ashertok1/BowelProbe/BowelProbe_Wordmark.jpeg

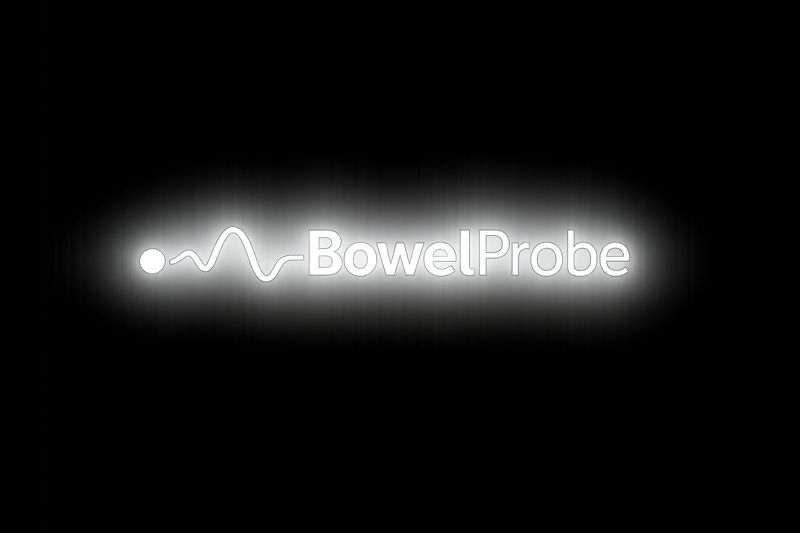
BowelProbe_Wordmark.jpeg
