ashertok1/BowelProbe/bowelProbeBlackAndWhite1.png

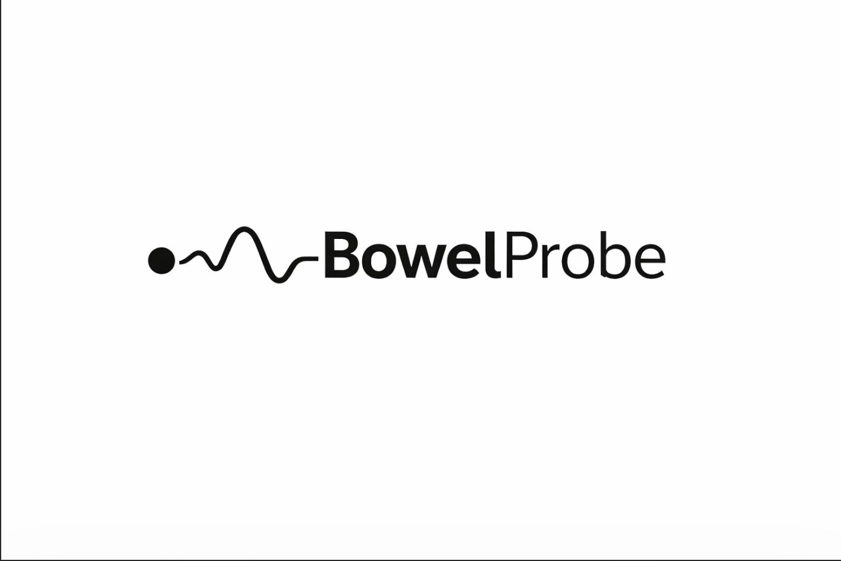
bowelProbeBlackAndWhite1.png
