ashertok1/BowelProbe/bowelProbeBlackAndWhite2.png

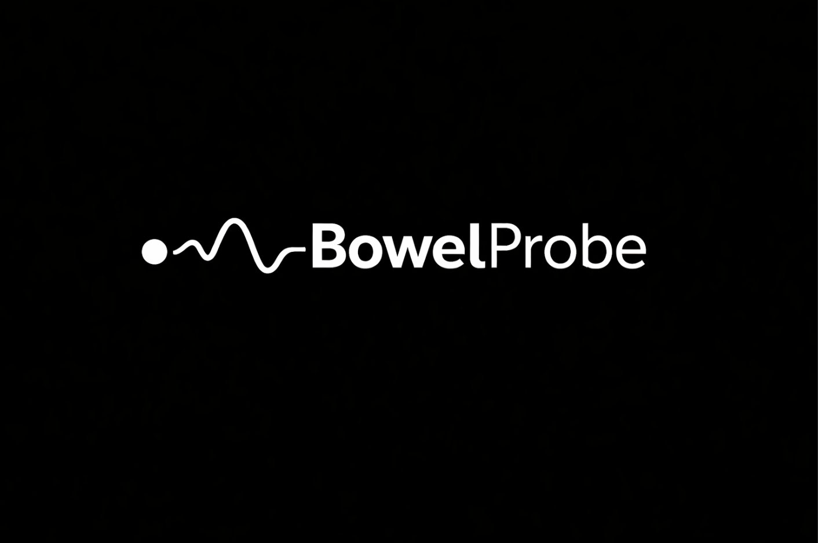
bowelProbeBlackAndWhite2.png
