ashertok1/BowelProbe/bowelProbe_3D/AO3407A.step

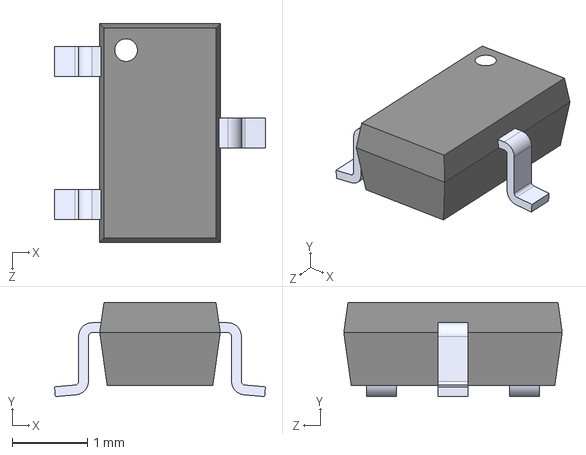
[picture p4: CAD file, 2026-07-04]
bowelProbe_3D/AO3407A.step
2.80 x 1.25 x 2.90 mm
