ashertok1/BowelProbe/HFSSsim/bowelProbe-drl_map.dxf

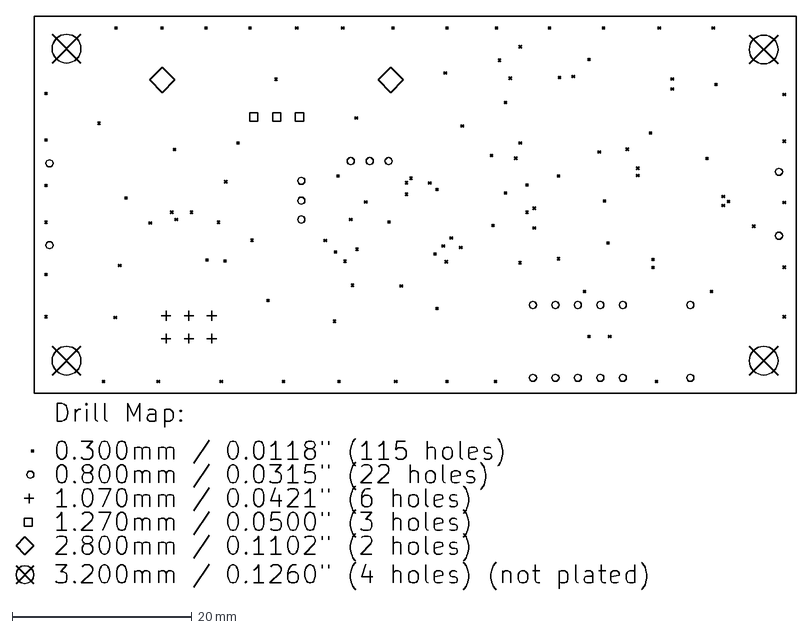
[picture p5: CAD file, 2026-03-30]
HFSSsim/bowelProbe-drl_map.dxf
86.7 x 63.8 mm
