ashertok1/BowelProbe/bowelProbe_3D/BZT52B12.step

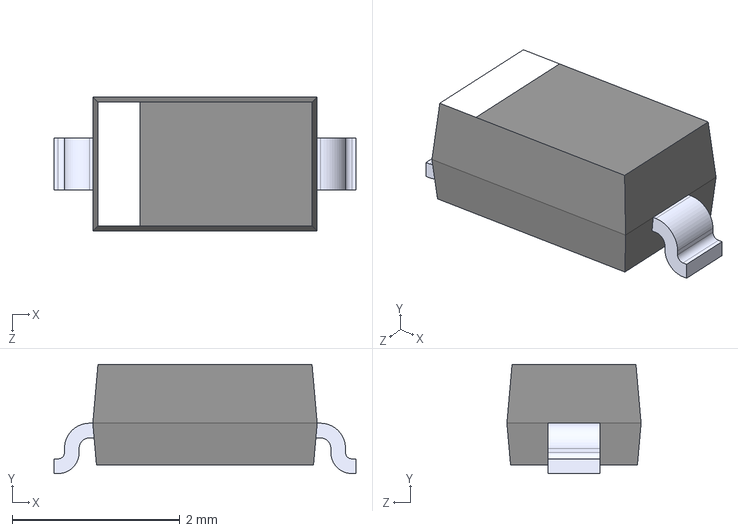
[picture p6: CAD file, 2026-07-04]
bowelProbe_3D/BZT52B12.step
3.60 x 1.30 x 1.60 mm
