ashertok1/BowelProbe/HFSSsim/.step

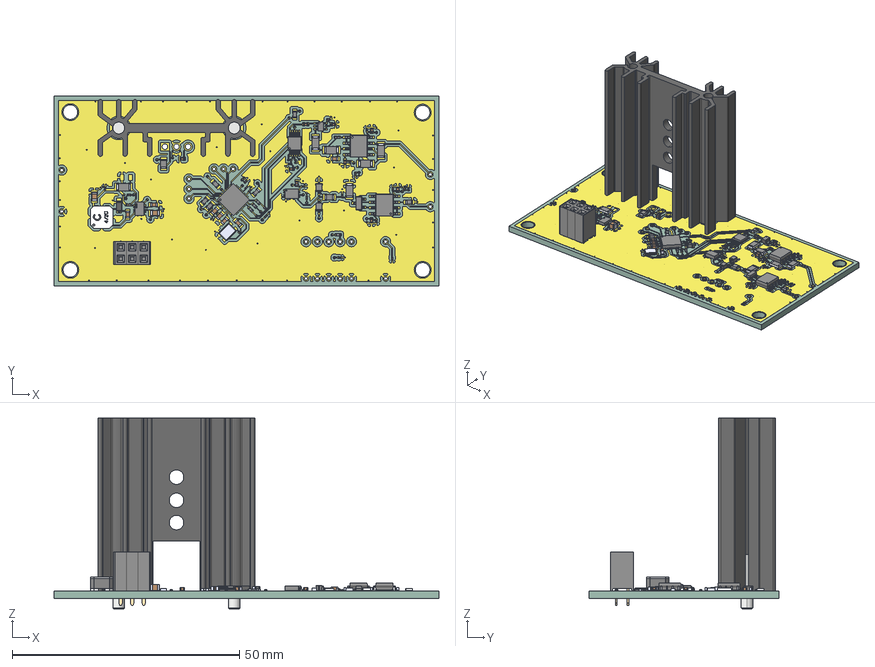
[picture p7: CAD file, 2026-03-30]
HFSSsim/.step
84.7 x 41.9 x 42.0 mm
Cap0.1uF x 22
Resistor6.8k x 2
Cap10uF x 9
Cap4.7pF
Resistor1M
CUS10S30,H3F x 2
MCP6002smd
Resistor10k x 4
Cap1uF x 4
Resistor47 x 4
NPPC202LFBN-RC_C03
Pin - Gold x 3
Buffer
Resistor1k x 2
DiodeLowLeak
Cap18pF x 2
Cap4.7uF x 2
Inductor10uH
Resistor100
Body001 (Mirror #1) x 8
XY-plane x 24
X-axis x 24
Crystal16MHz
Resistor30k
Cap2.2nF
Cap1nF
AD9833BRMZ
Resistor300k
LT8330
Heatsink
ATMEGA328P-MUR
Resistor1.8k
bowelProbe_copper
bowelProbe_PCB
