ashertok1/BowelProbe/bowelProbe_3D/Resistor100k.step

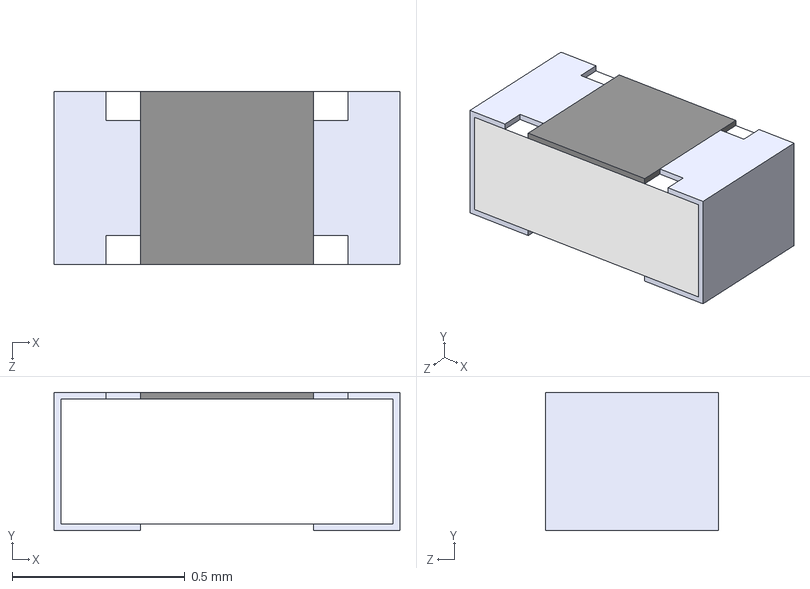
[picture p8: CAD file, 2026-07-04]
bowelProbe_3D/Resistor100k.step
1 x 0.4 x 0.5 mm
