ashertok1/BowelProbe/bowelProbe_3D/SN74LVC1G86DBVR.step

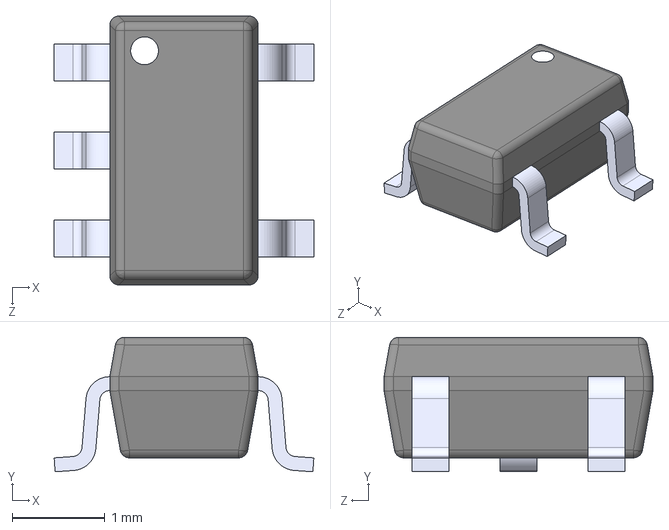
[picture p9: CAD file, 2026-07-04]
bowelProbe_3D/SN74LVC1G86DBVR.step
2.80 x 1.45 x 2.90 mm
