ashertok1/BowelProbe/bowelProbe_3D/LM319MX_NOPB.step

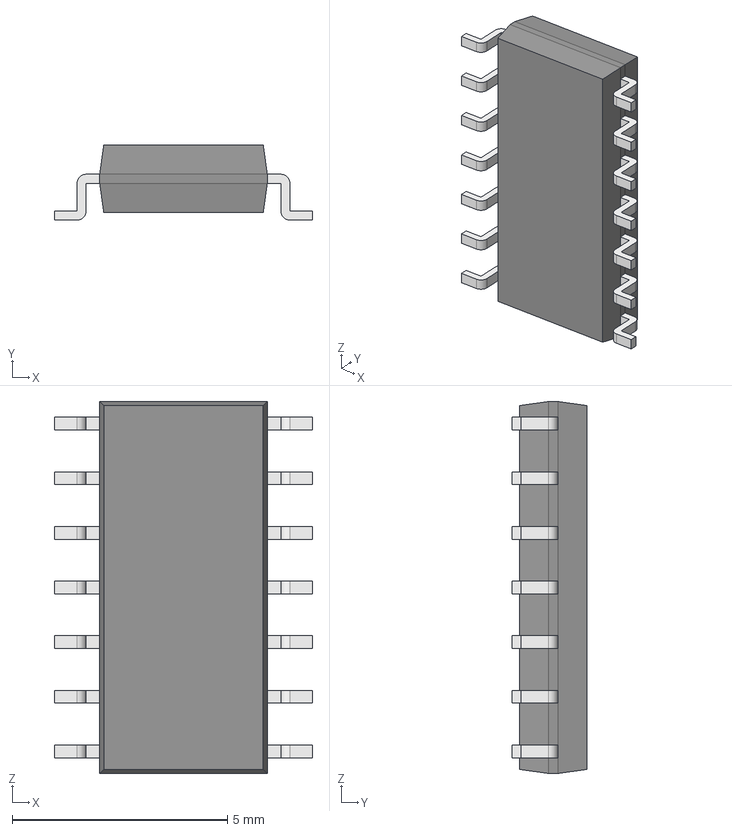
[picture p10: CAD file, 2026-07-04]
bowelProbe_3D/LM319MX_NOPB.step
6.00 x 1.75 x 8.65 mm
Body001 (Mirror #1) x 7
XY-plane x 12
X-axis x 12
