ashertok1/BowelProbe/bowelProbe_3D/LM3480IM3-12_NOPB.STEP

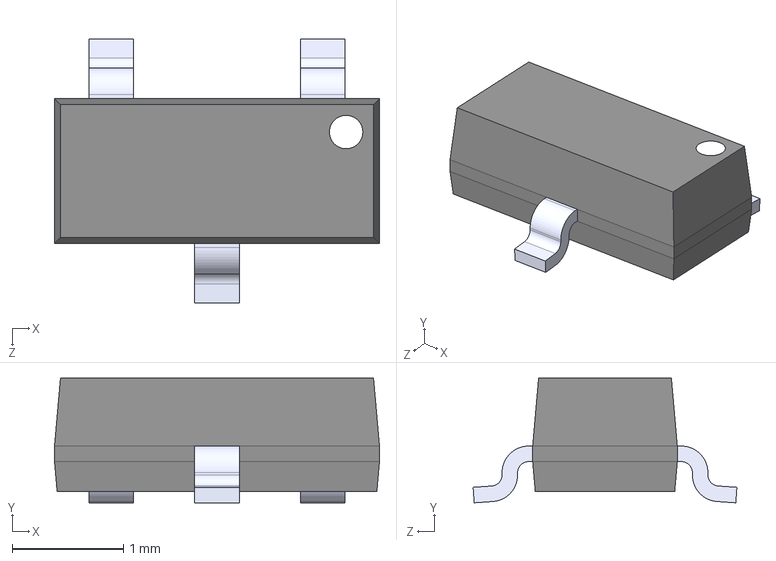
[picture p11: CAD file, 2026-06-26]
bowelProbe_3D/LM3480IM3-12_NOPB.STEP
2.92 x 1.12 x 2.37 mm
