ashertok1/BowelProbe/bowelProbe_3D/Inductor4.7uReplacement.STP

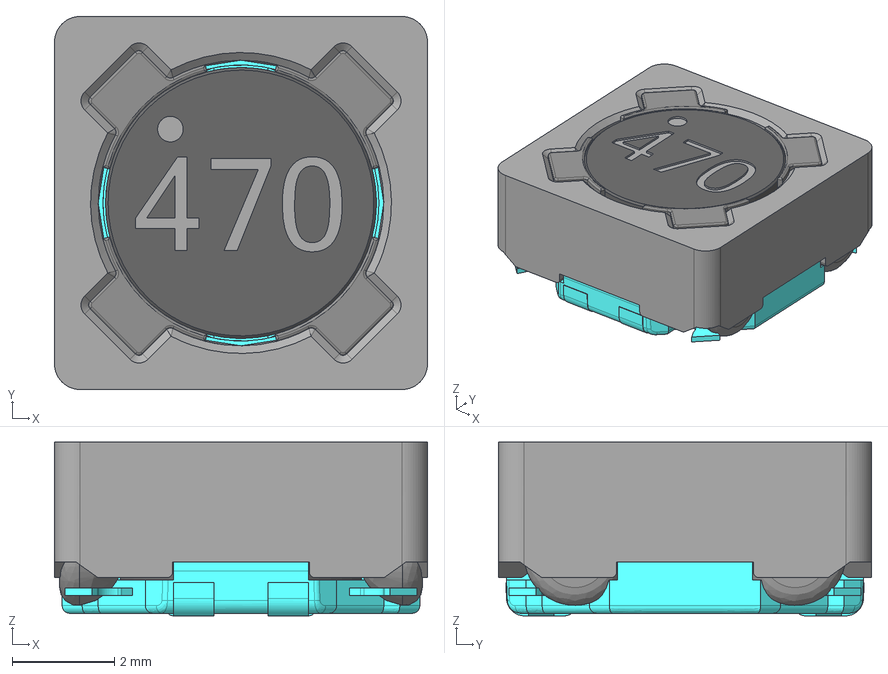
[picture p12: CAD file, 2026-04-04]
bowelProbe_3D/Inductor4.7uReplacement.STP
7.30 x 7.30 x 3.40 mm
PIN
C001603
200926base
