ashertok1/BowelProbe/bowelProbe_3D/SchottkyReplacement.STEP

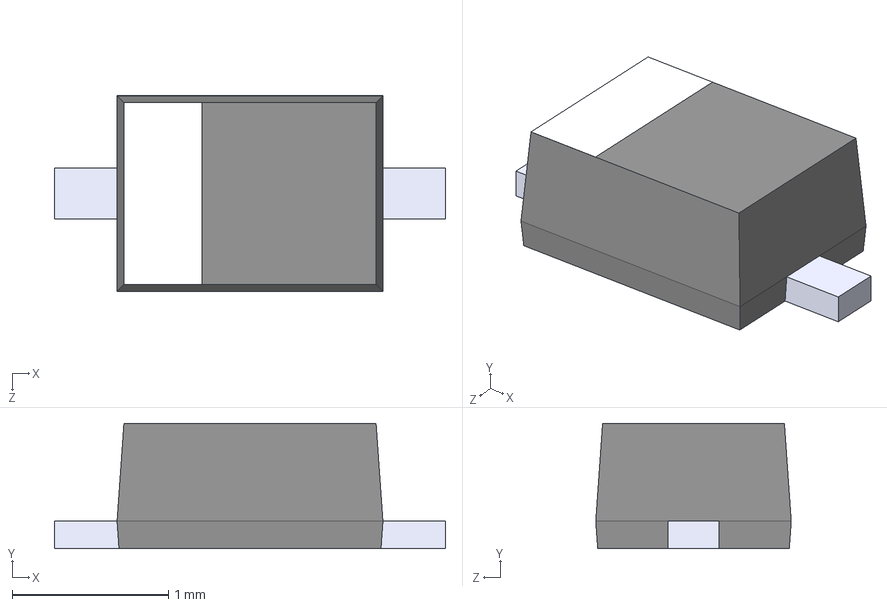
[picture p13: CAD file, 2026-04-04]
bowelProbe_3D/SchottkyReplacement.STEP
2.50 x 0.8 x 1.25 mm
