ashertok1/BowelProbe/bowelProbe_3D/Buffer.step

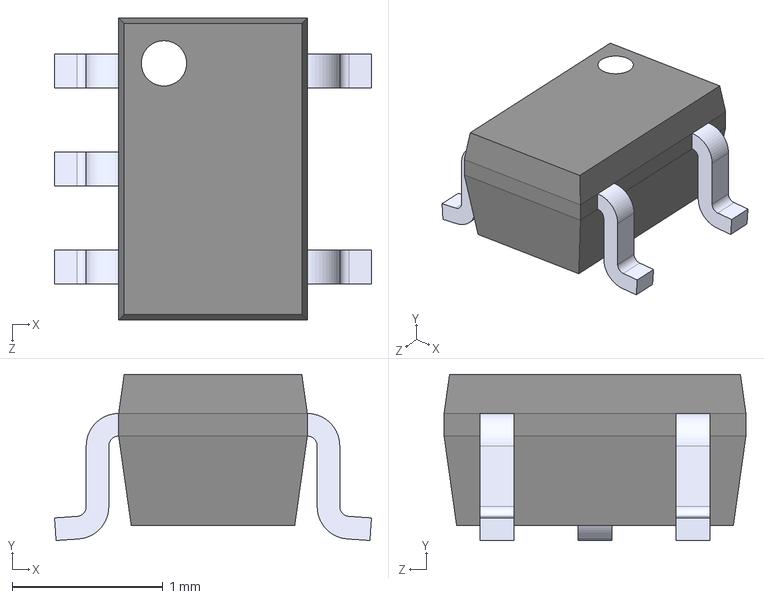
[picture p14: CAD file, 2026-03-27]
bowelProbe_3D/Buffer.step
2.10 x 1.10 x 2.00 mm
