ashertok1/BowelProbe/bowelProbe_3D/Dupont2x3.STEP

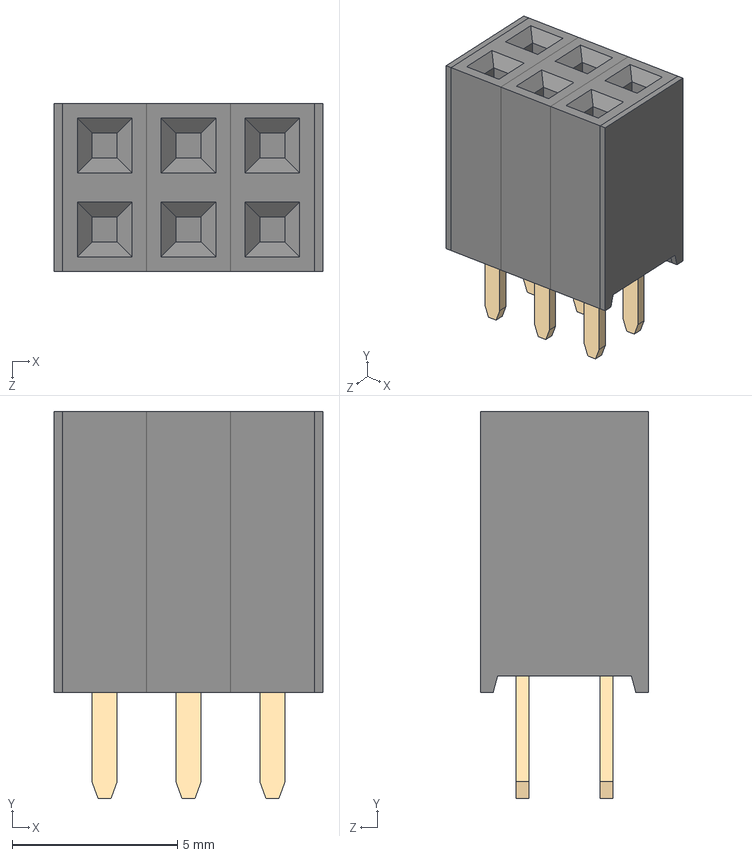
[picture p15: CAD file, 2026-03-23]
bowelProbe_3D/Dupont2x3.STEP
8.13 x 11.7 x 5.08 mm
NPPC202LFBN-RC_C03
Pin - Gold x 3
