ashertok1/BowelProbe/bowelProbe_3D/Resistor71.5k.STEP

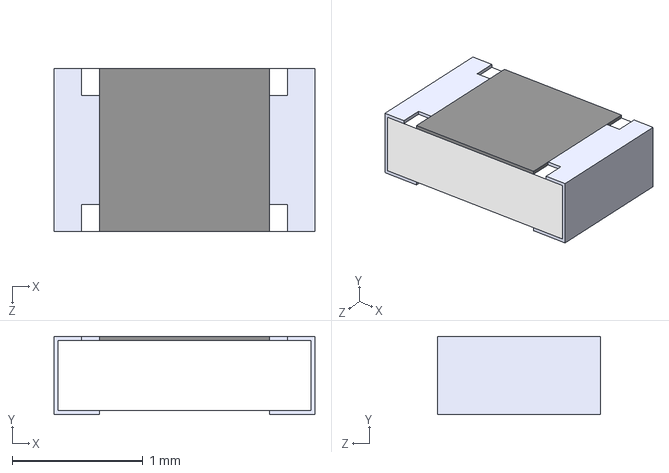
[picture p16: CAD file, 2026-03-23]
bowelProbe_3D/Resistor71.5k.STEP
2.00 x 0.6 x 1.25 mm
