ashertok1/BowelProbe/bowelProbe_3D/AD9833BRMZ.STEP

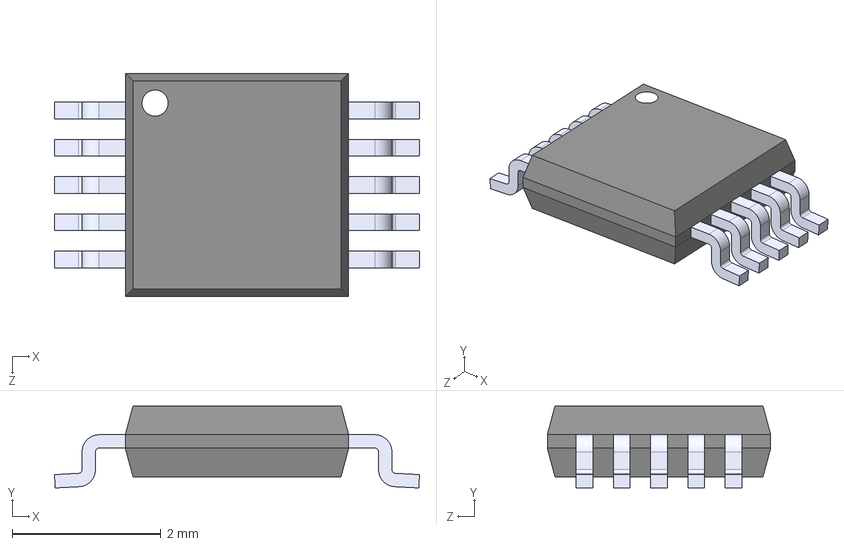
[picture p17: CAD file, 2026-03-23]
bowelProbe_3D/AD9833BRMZ.STEP
4.90 x 1.10 x 3.00 mm
