ashertok1/BowelProbe/bowelProbe_3D/Resistor10k.STEP

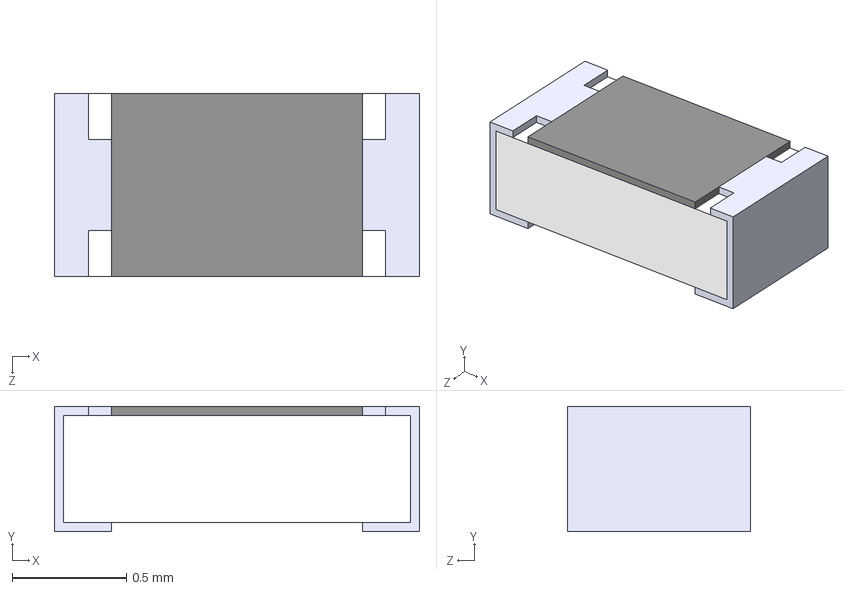
[picture p18: CAD file, 2026-03-23]
bowelProbe_3D/Resistor10k.STEP
1.60 x 0.55 x 0.8 mm
