ashertok1/BowelProbe/bowelProbe_3D/Inductor10uH.STEP

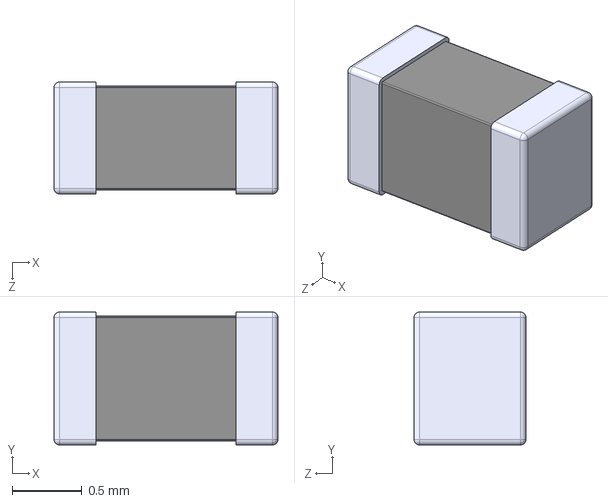
[picture p20: CAD file, 2026-03-23]
bowelProbe_3D/Inductor10uH.STEP
1.60 x 0.95 x 0.8 mm
