ashertok1/BowelProbe/bowelProbe_3D/Resistor1k.STEP

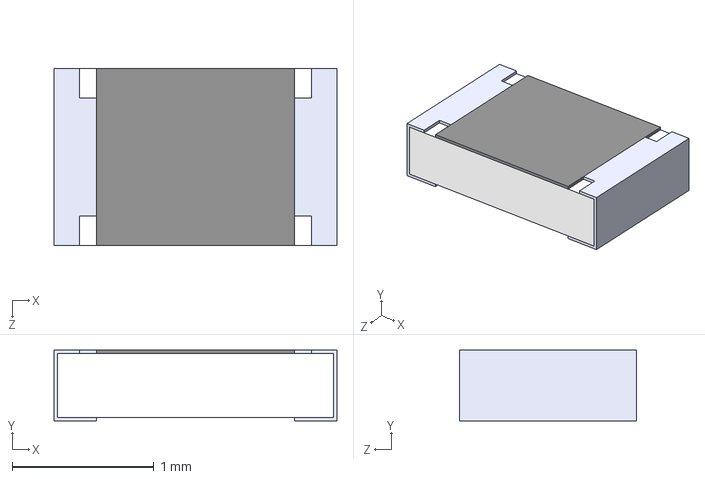
[picture p21: CAD file, 2026-03-23]
bowelProbe_3D/Resistor1k.STEP
2.00 x 0.5 x 1.25 mm
