ashertok1/BowelProbe/bowelProbe_3D/Resistor300k.STEP

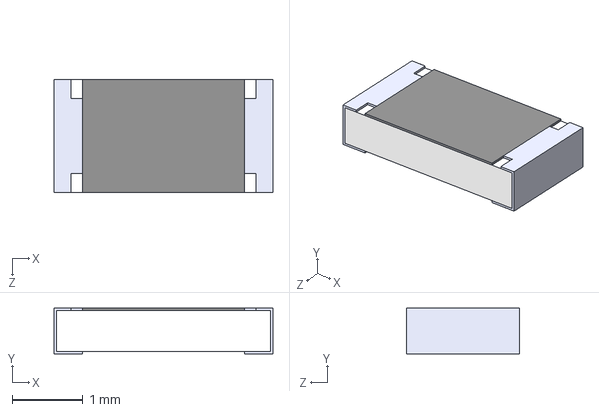
[picture p22: CAD file, 2026-03-23]
bowelProbe_3D/Resistor300k.STEP
3.10 x 0.65 x 1.60 mm
