ashertok1/BowelProbe/bowelProbe_3D/Heatsink.STEP

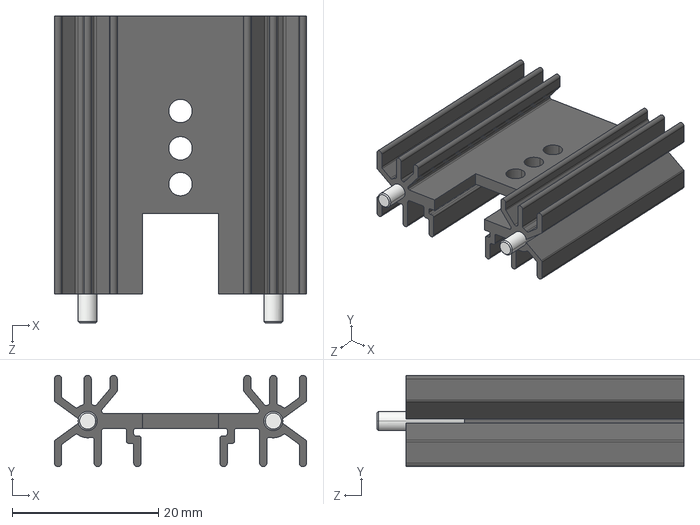
[picture p23: CAD file, 2026-03-23]
bowelProbe_3D/Heatsink.STEP
34.5 x 12.5 x 42.0 mm
