ashertok1/BowelProbe/bowelProbe_3D/Cap0.1uF.STEP

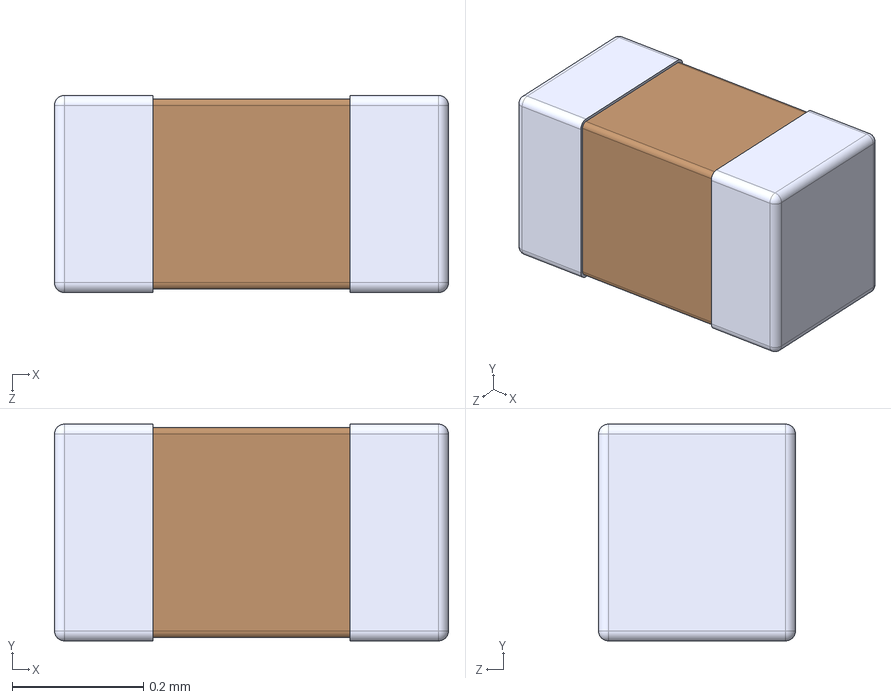
[picture p24: CAD file, 2026-03-23]
bowelProbe_3D/Cap0.1uF.STEP
0.6 x 0.33 x 0.3 mm
