ashertok1/BowelProbe/bowelProbe_3D/SchottkyDiode.step

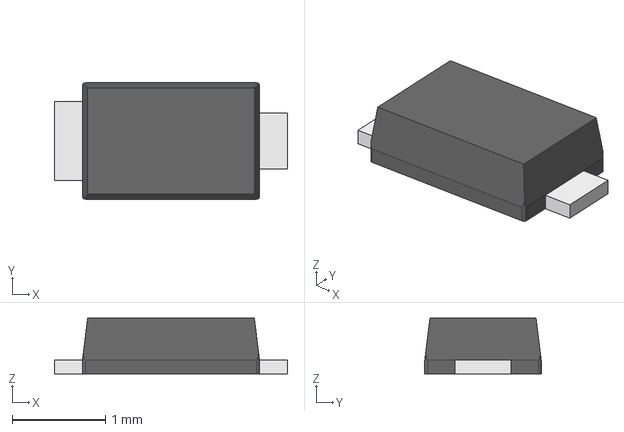
[picture p25: CAD file, 2026-03-23]
bowelProbe_3D/SchottkyDiode.step
2.50 x 1.25 x 0.6 mm
