ashertok1/BowelProbe/bowelProbe_3D/Cap1nF.STEP

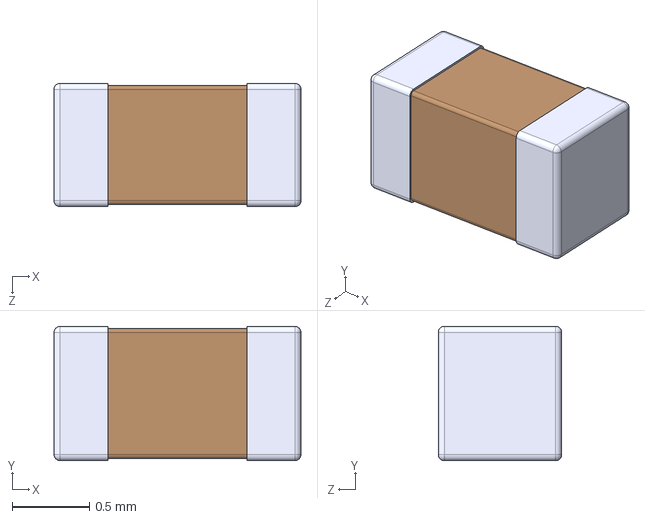
[picture p26: CAD file, 2026-03-23]
bowelProbe_3D/Cap1nF.STEP
1.60 x 0.87 x 0.8 mm
