ashertok1/BowelProbe/bowelProbe_3D/ATMEGA328P-MUR.STEP

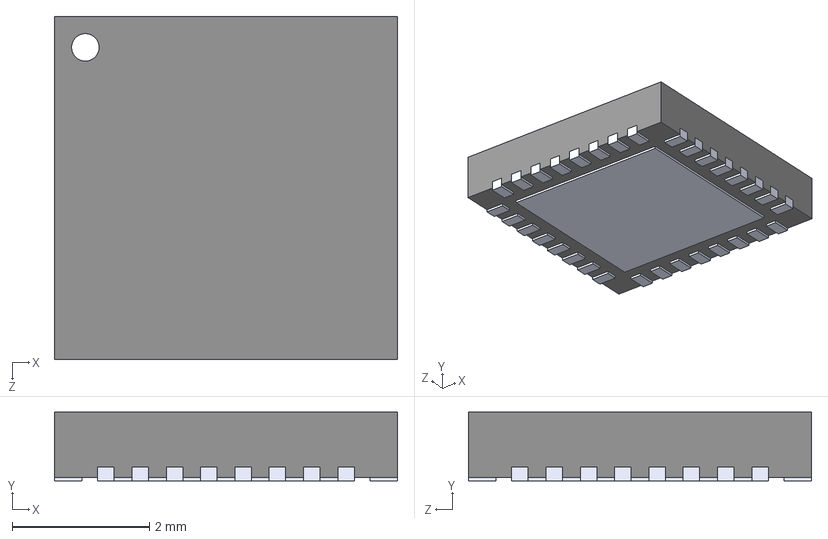
[picture p27: CAD file, 2026-03-23]
bowelProbe_3D/ATMEGA328P-MUR.STEP
5.00 x 1.00 x 5.00 mm
