ashertok1/BowelProbe/bowelProbe_3D/LT8330.STEP

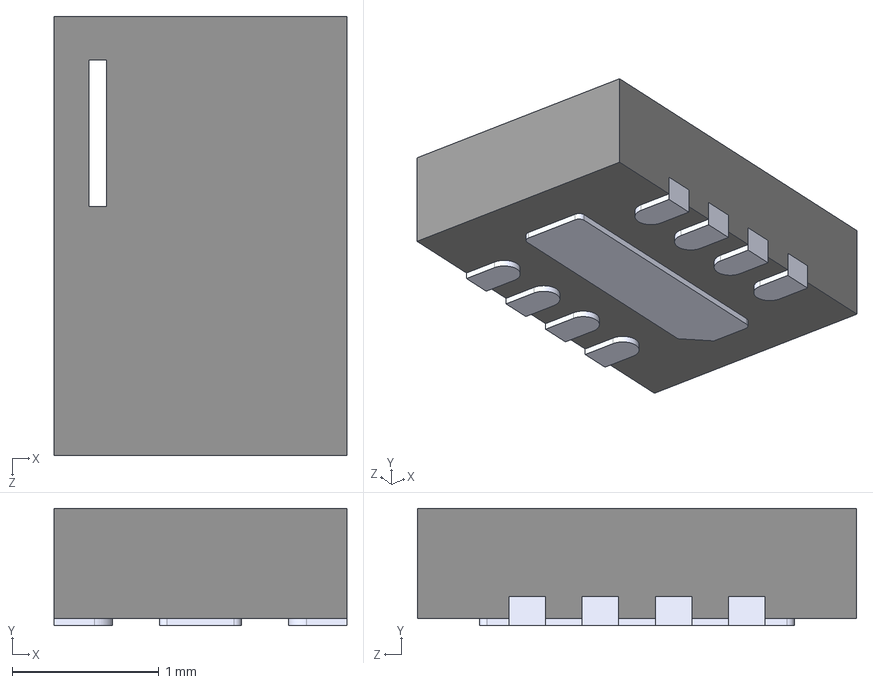
[picture p28: CAD file, 2026-03-23]
bowelProbe_3D/LT8330.STEP
2.00 x 0.8 x 3.00 mm
