ashertok1/BowelProbe/bowelProbe_3D/Cap4.7pF.STEP

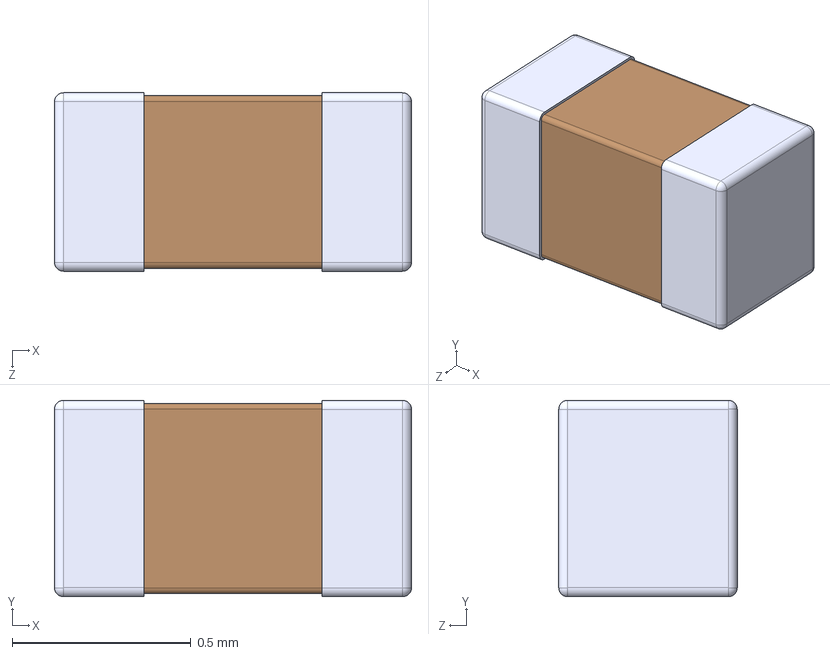
[picture p29: CAD file, 2026-03-23]
bowelProbe_3D/Cap4.7pF.STEP
1.00 x 0.55 x 0.5 mm
