ashertok1/BowelProbe/bowelProbe_3D/L7905CV-DG.STEP

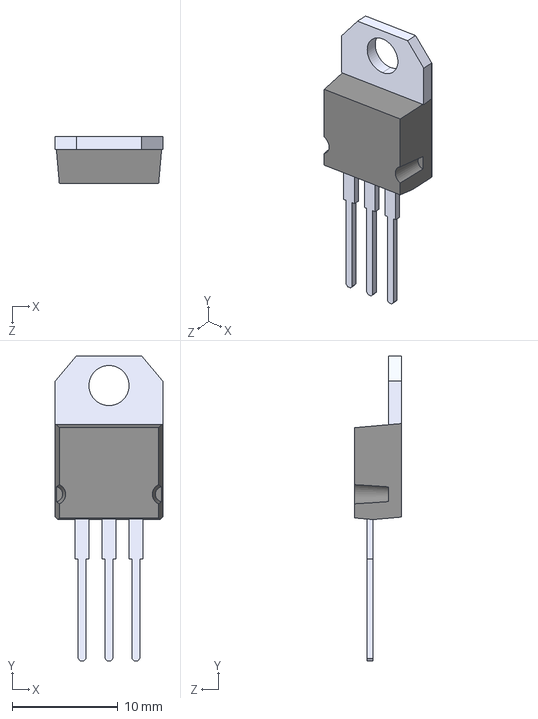
[picture p30: CAD file, 2026-03-23]
bowelProbe_3D/L7905CV-DG.STEP
10.2 x 28.9 x 4.50 mm
