ashertok1/BowelProbe/bowelProbe_3D/Cap1uF.STEP

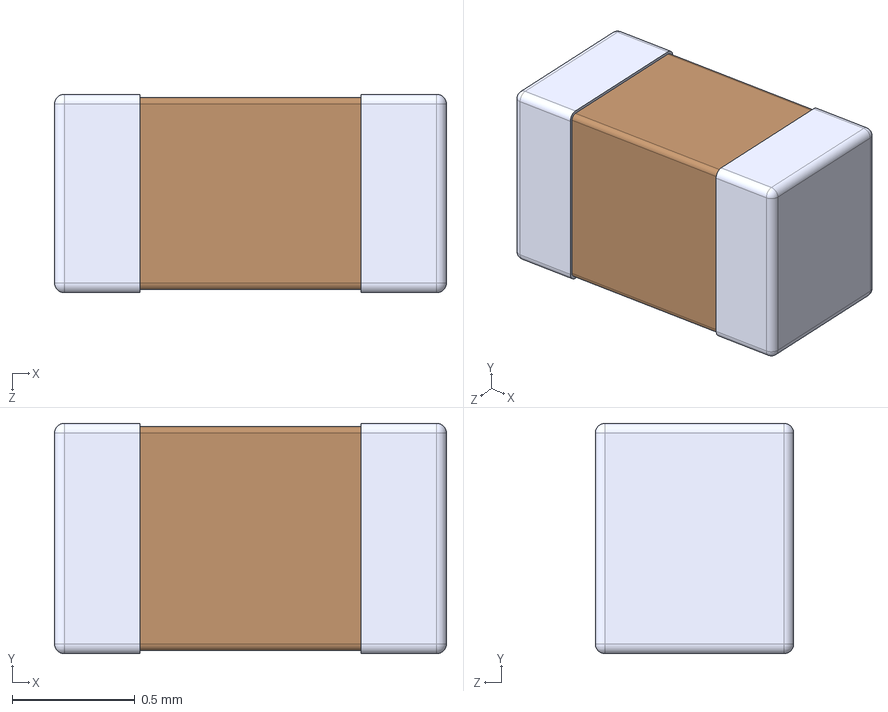
[picture p31: CAD file, 2026-03-23]
bowelProbe_3D/Cap1uF.STEP
1.60 x 0.94 x 0.81 mm
