ashertok1/BowelProbe/bowelProbe_3D/LM393ADR.step

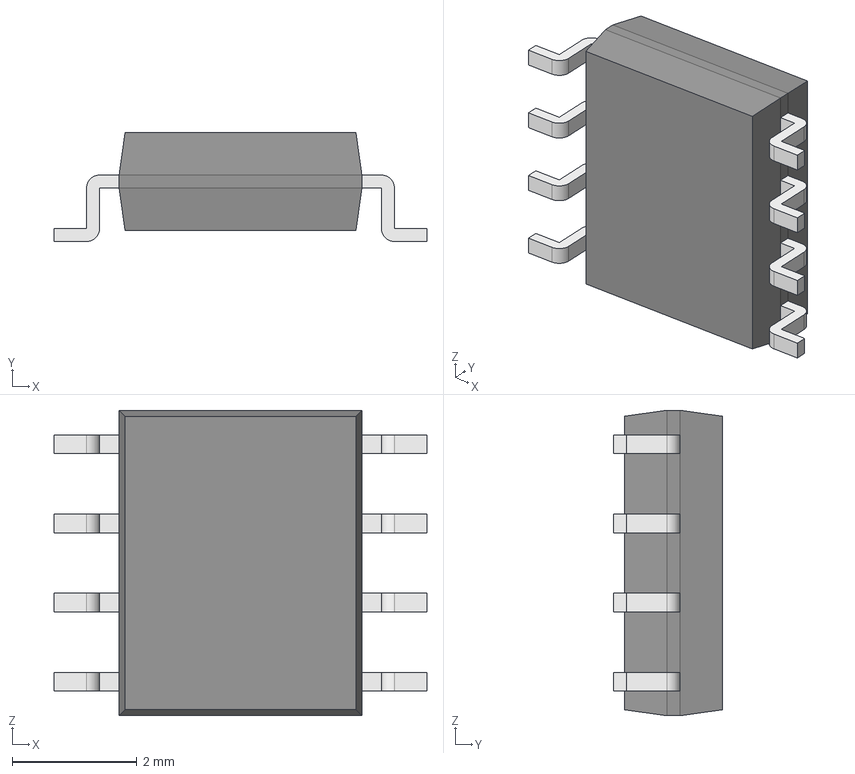
[picture p32: CAD file, 2026-03-23]
bowelProbe_3D/LM393ADR.step
5.99 x 1.75 x 4.91 mm
Body001 (Mirror #1) x 4
XY-plane x 12
X-axis x 12
