ashertok1/BowelProbe/bowelProbe_3D/Cap10uF.STEP

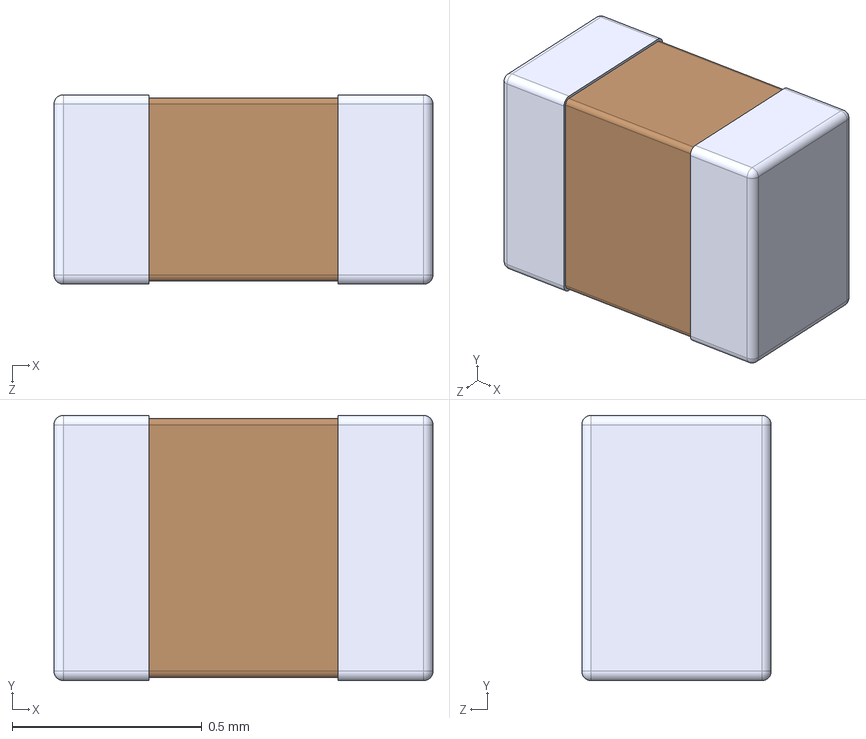
[picture p33: CAD file, 2026-03-23]
bowelProbe_3D/Cap10uF.STEP
1.00 x 0.7 x 0.5 mm
