ashertok1/BowelProbe/bowelProbe_3D/MCP6002smd.STEP

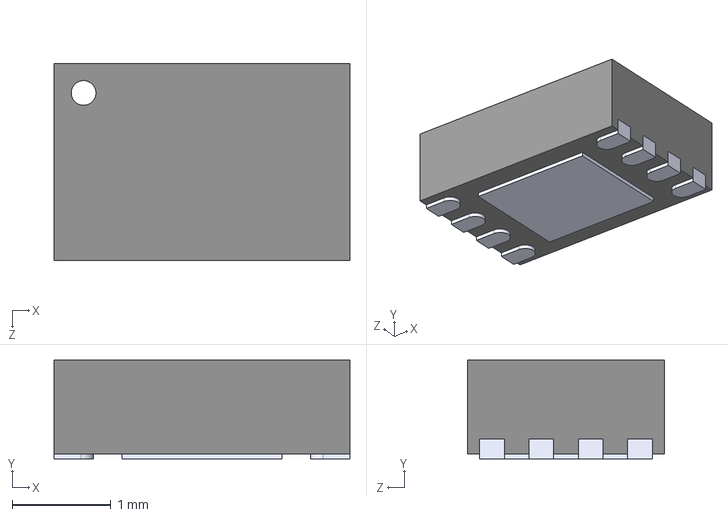
[picture p34: CAD file, 2026-03-23]
bowelProbe_3D/MCP6002smd.STEP
3.00 x 1.00 x 2.00 mm
