ashertok1/BowelProbe/bowelProbe_3D/Resistor100.STEP

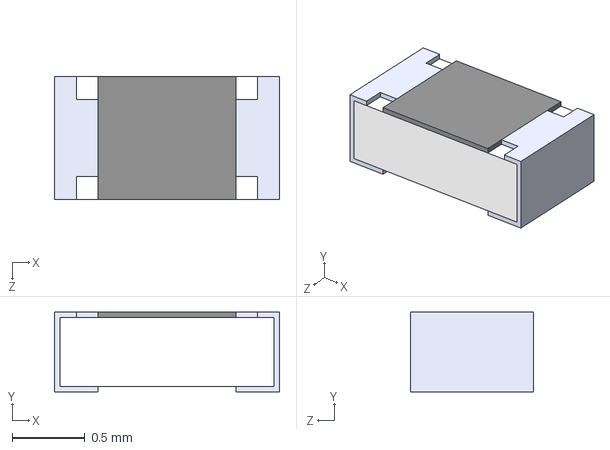
[picture p35: CAD file, 2026-03-23]
bowelProbe_3D/Resistor100.STEP
1.55 x 0.55 x 0.85 mm
