ashertok1/BowelProbe/bowelProbe_3D/DiodeLowLeak.STEP

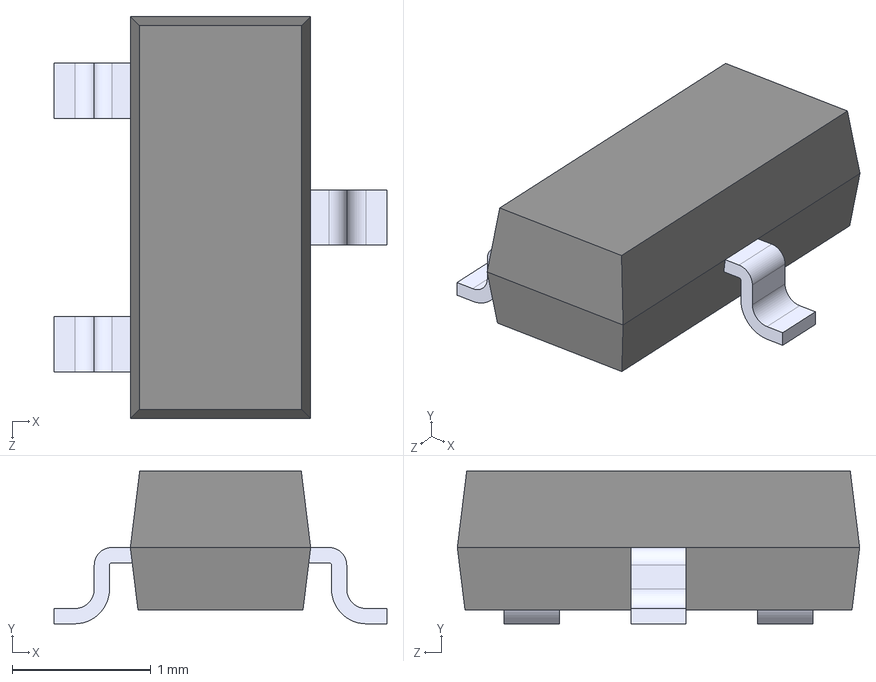
[picture p36: CAD file, 2026-03-23]
bowelProbe_3D/DiodeLowLeak.STEP
2.40 x 1.10 x 2.90 mm
