ashertok1/BowelProbe/bowelProbe_3D/InductorCoupled.step

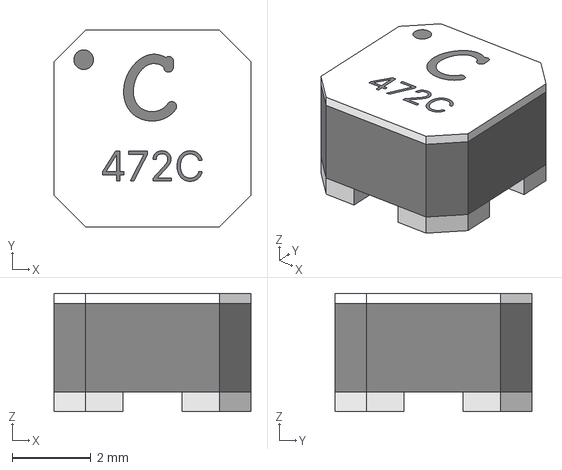
[picture p37: CAD file, 2026-03-23]
bowelProbe_3D/InductorCoupled.step
5.00 x 5.00 x 3.00 mm
