ashertok1/BowelProbe/bowelProbe_3D/DiodeClamper.STEP

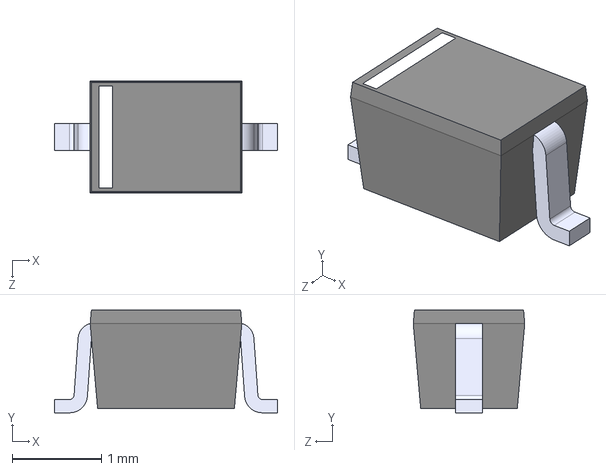
[picture p38: CAD file, 2026-03-23]
bowelProbe_3D/DiodeClamper.STEP
2.50 x 1.15 x 1.25 mm
