ashertok1/BowelProbe/bowelProbe_3D/Crystal16MHz.STEP

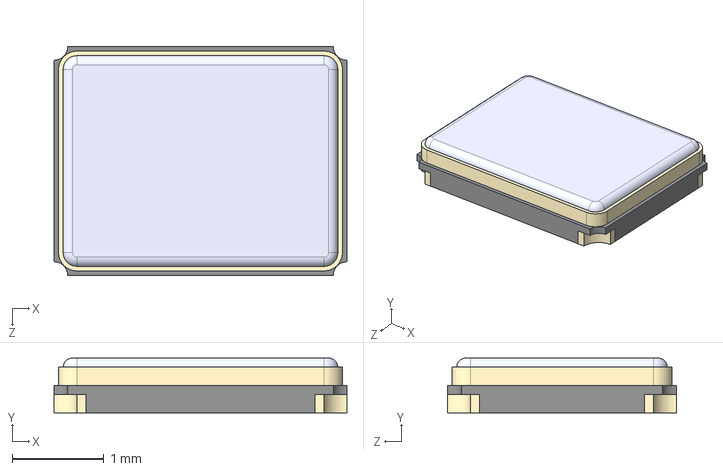
[picture p39: CAD file, 2026-03-23]
bowelProbe_3D/Crystal16MHz.STEP
3.20 x 0.6 x 2.50 mm
