ashertok1/BowelProbe/bowelProbe_3D/Cap4.7uF.STEP

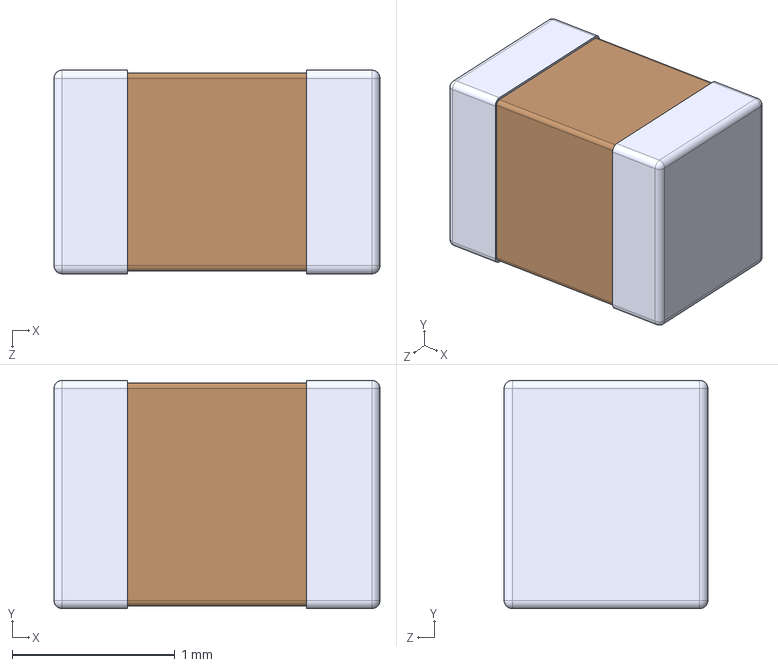
[picture p40: CAD file, 2026-03-23]
bowelProbe_3D/Cap4.7uF.STEP
2.00 x 1.40 x 1.25 mm
