ashertok1/BowelProbe/bowelProbe_3D/CT3149-5.step

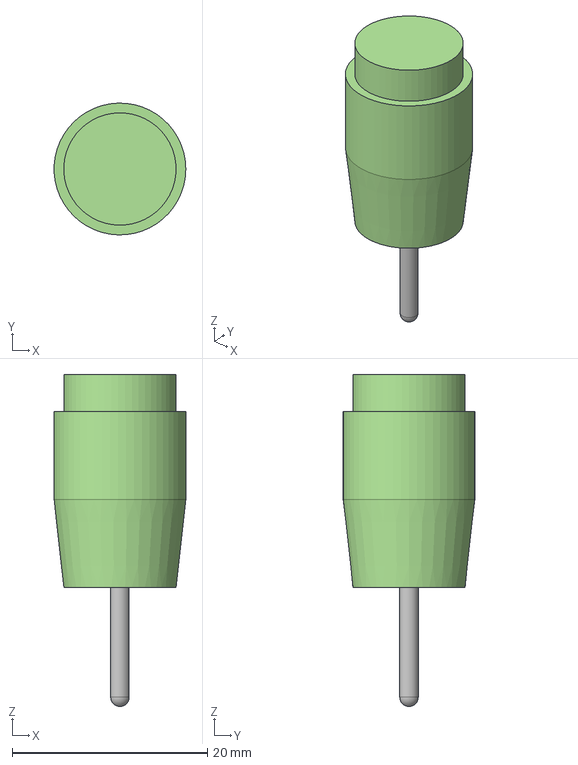
[picture p41: CAD file, 2026-01-19]
bowelProbe_3D/CT3149-5.step
13.5 x 13.5 x 34.0 mm
