ashertok1/BowelProbe/bowelProbe_3D/MAX038CPP.stp

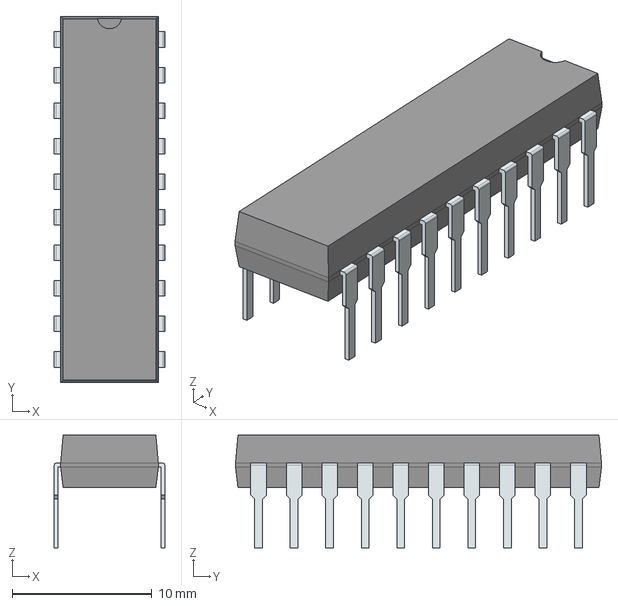
[picture p42: CAD file, 2026-01-19]
bowelProbe_3D/MAX038CPP.stp
7.90 x 26.2 x 8.07 mm
PinsArrayLR
