ashertok1/BowelProbe/bowelProbe_3D/Capacitor-10u.STEP

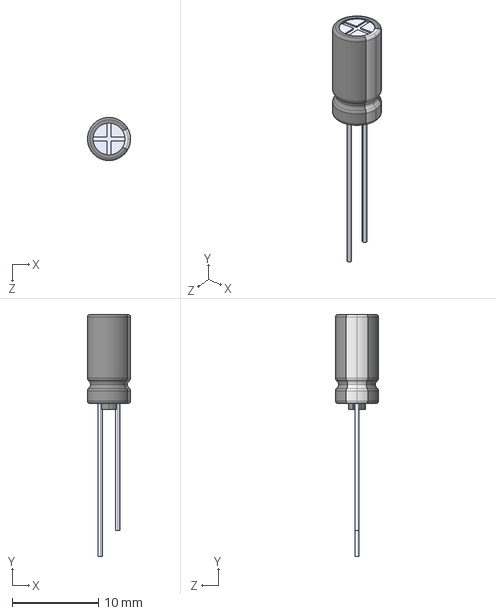
[picture p43: CAD file, 2026-01-19]
bowelProbe_3D/Capacitor-10u.STEP
5.00 x 28.0 x 4.99 mm
