ashertok1/BowelProbe/bowelProbe_3D/MCP6002-E_P.STEP

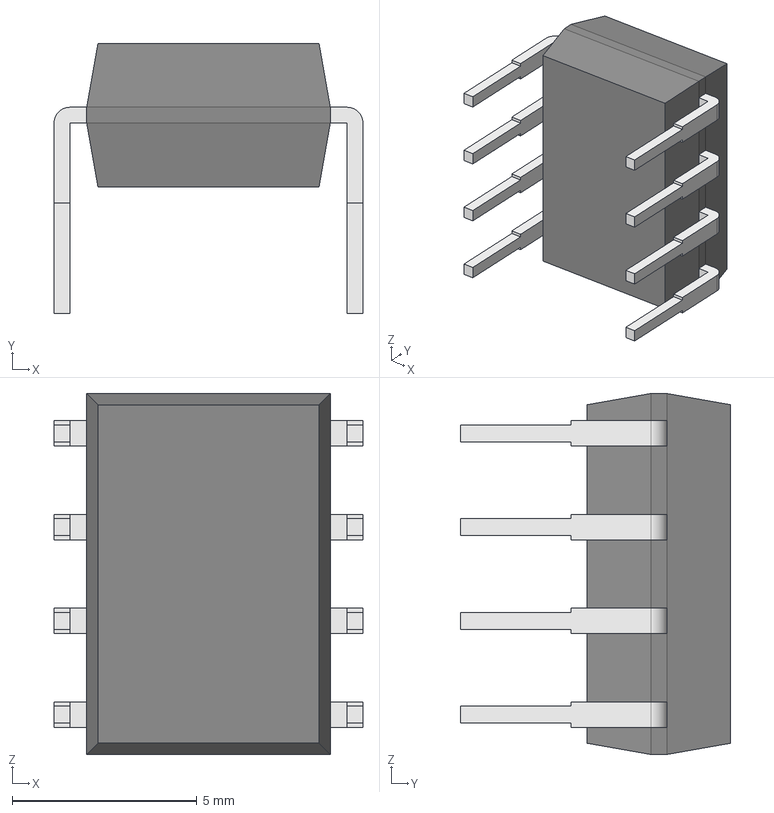
[picture p44: CAD file, 2026-01-19]
bowelProbe_3D/MCP6002-E_P.STEP
8.37 x 7.32 x 9.78 mm
Body001 (Mirror #1) x 5
