ashertok1/BowelProbe/bowelProbe_3D/Capacitor-10n.STEP

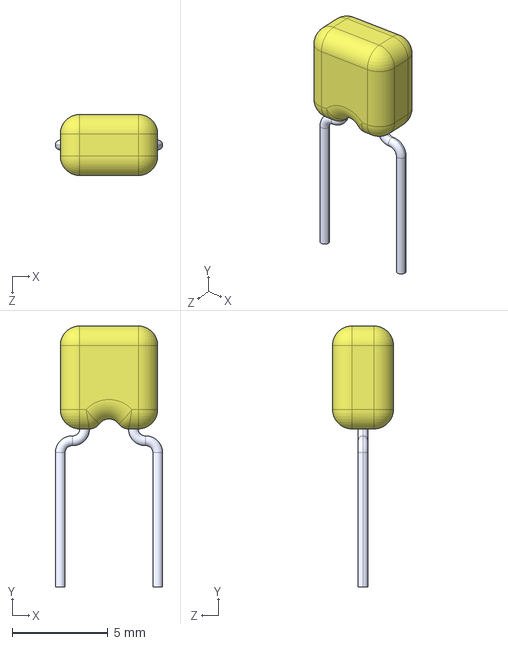
[picture p45: CAD file, 2026-01-19]
bowelProbe_3D/Capacitor-10n.STEP
5.59 x 13.6 x 3.18 mm
