ashertok1/BowelProbe/bowelProbe_3D/Resistor-20k.STEP

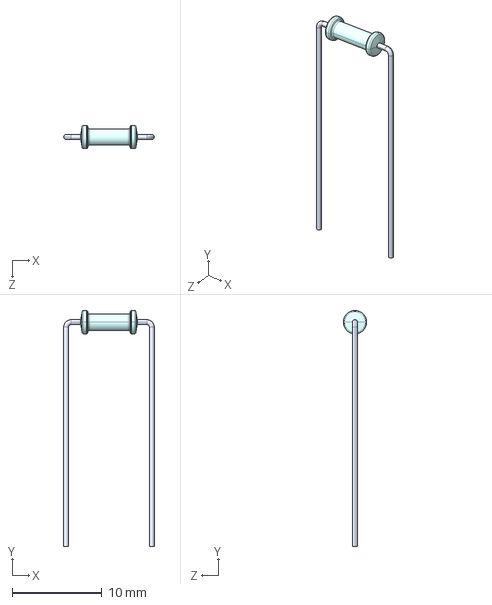
[picture p46: CAD file, 2026-01-19]
bowelProbe_3D/Resistor-20k.STEP
10.1 x 26.3 x 2.60 mm
