ashertok1/BowelProbe/bowelProbe_3D/OPA2134PA.STEP

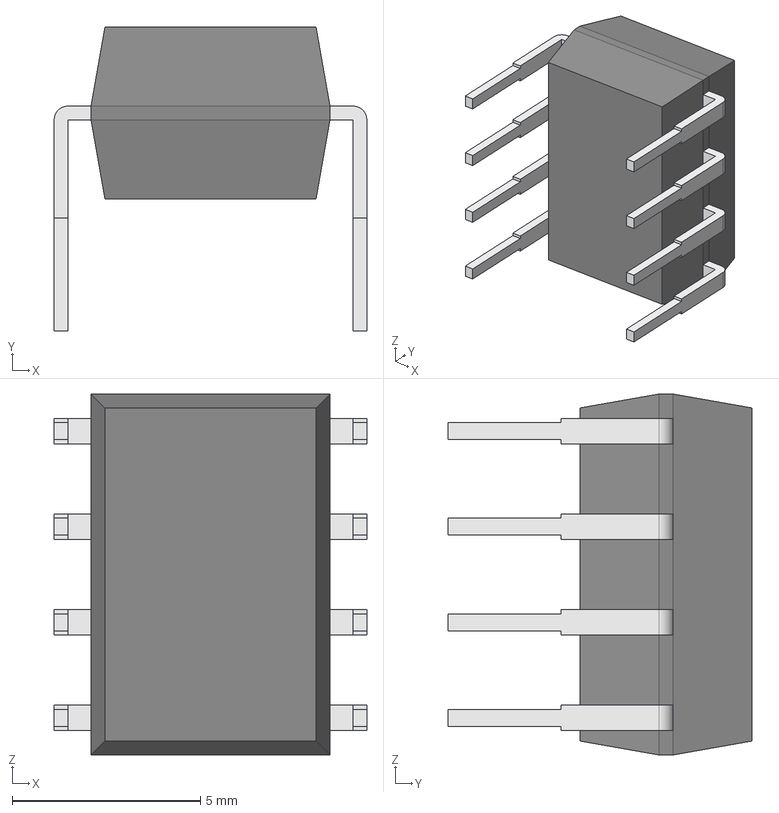
[picture p47: CAD file, 2026-01-19]
bowelProbe_3D/OPA2134PA.STEP
8.31 x 8.08 x 9.59 mm
Body001 (Mirror #1) x 5
