ashertok1/BowelProbe/bowelProbe_3D/1N5817.STEP

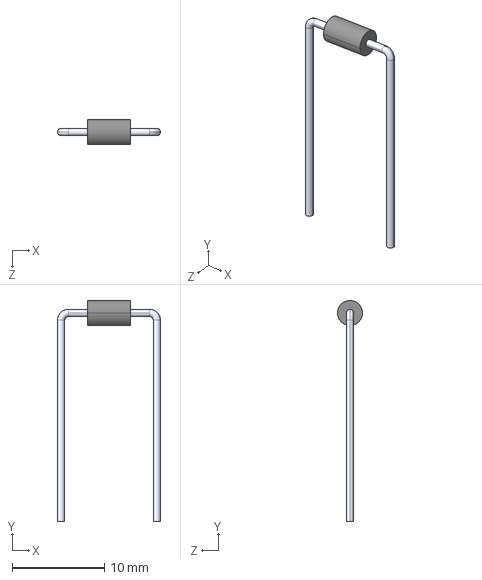
[picture p48: CAD file, 2026-01-19]
bowelProbe_3D/1N5817.STEP
11.1 x 23.9 x 2.70 mm
