ashertok1/BowelProbe/(list of files, cad)

Other CAD files:
bowelProbe_3D/Resistor47.STEP
bowelProbe_3D/Cap18pF.STEP
bowelProbe_3D/Cap2.2nF.STEP
bowelProbe_3D/CT3149-0.step
bowelProbe_3D/CT3149-2.step
HFSSsim/SimulationEMI.aedtresults/mf_0/GeometryCache/BodyCache/0029364.x_b
HFSSsim/SimulationEMI.aedtresults/mf_0/GeometryCache/BodyCache/0029474.x_b
HFSSsim/SimulationEMI.aedtresults/mf_0/GeometryCache/BodyCache/0029502.x_b
HFSSsim/SimulationEMI.aedtresults/mf_0/GeometryCache/BodyCache/0084060.x_b
HFSSsim/SimulationEMI.aedtresults/mf_0/GeometryCache/BodyCache/0166742.x_b
