ashertok1/BowelProbe/LTspiceSim/ReversePolarityProtection.asc

C1: cap; .1µ
D1: diode; BZT52B12
R1: res; 10k
R3: res; 100k
U1: AO3407A
V1: voltage; PULSE(-20 20 0 10u 10u 25m 50m)
Named nets: nVin, nVinProtected, 0
.include AO3407A.lib
.include BZT52B12.lib
.tran 0 100m 0 100u startup
