ashertok1/BowelProbe/LTspiceSim/Stage4Probe_Buffer_and_Phase_Detector.asc

C1: cap; 0.1µ; V=16 Irms=0.6 Rser=0.05
C2: cap; 10µ; V=10 Irms=1.25 Rser=5m
C3: cap; 0.1µ; V=16 Irms=0.6 Rser=0.05
C4: cap; 10µ; V=10 Irms=1.25 Rser=5m
C5: cap; 0.1µ; V=16 Irms=0.6 Rser=0.05
C6: cap; 10µ; V=10 Irms=1.25 Rser=5m
C7: cap; 0.1µ; V=16 Irms=0.6 Rser=0.05
C8: cap; 10µ; V=10 Irms=1.25 Rser=5m
C9: cap; 0.1µ; V=16 Irms=0.6 Rser=0.05
C10: cap; 10µ; V=10 Irms=1.25 Rser=5m
C11: cap; 0.1µ; V=16 Irms=0.6 Rser=0.05
C12: cap; 10µ; V=10 Irms=1.25 Rser=5m
C13: cap; 0.1µ; V=16 Irms=0.6 Rser=0.05
C14: cap; 10µ; V=10 Irms=1.25 Rser=5m
C15: cap; .1µ
C16: cap; 1µ
C17: cap; .1µ
Probe: res; 218
R1: res; 100; tol=1 pwr=0.5
R2: res; 10k
R3: res; 10k
R4: res; 30k
R5: res; 30k
U1: opamp2; TL07XH_TL08XH
U2: LM311
U3: LM311
U4: SN74LVC1G86
V1: voltage; 12
V2: voltage; 5; Rser=312m
V3: voltage; 12; Rser=0.05
VAmplified: voltage; SINE(0 5 500)
Named nets: 0, nVss, nVdd5, nVdd12, nAmplified, nProbe, nBuffer2, A, B, nPD
.tran 0 500m 0 1m startup
.include tl07xh_tl08xh.txt
.include lm311.lib
.include SN74LVC1G86.lib
