ashertok1/BowelProbe/LTspiceSim/CircuitSimulation.asc

C1: cap; 10µ; V=10 Irms=1.25 Rser=5m
C2: cap; 0.1µ; V=16 Irms=0.6 Rser=0.05
C3: cap; 10µ; V=10 Irms=1.25 Rser=5m
C4: cap; 0.1µ; V=16 Irms=0.6 Rser=0.05
C5: cap; 10µ; V=10 Irms=1.25 Rser=5m
C6: cap; 1n; V=50 Irms=0.2 Rser=300m
C7: cap; 2.2n; V=50 Irms=0.15 Rser=250m
C8: cap; 0.1µ; V=16 Irms=0.6 Rser=0.05
C9: cap; 10µ; V=10 Irms=1.25 Rser=5m
C10: cap; 0.1µ; V=16 Irms=0.6 Rser=0.05
C13: cap; 10µ; V=10 Irms=1.25 Rser=5m
C14: cap; 0.1µ; V=16 Irms=0.6 Rser=0.05
C15: cap; 10µ; V=10 Irms=1.25 Rser=5m
C16: cap; 0.1µ; V=16 Irms=0.6 Rser=0.05
C17: cap; 10µ; V=10 Irms=1.25 Rser=5m
C18: cap; 0.1µ; V=16 Irms=0.6 Rser=0.05
C19: cap; 10µ; V=10 Irms=1.25 Rser=5m
C20: cap; 0.1µ; V=16 Irms=0.6 Rser=0.05
C21: cap; 10µ; V=10 Irms=1.25 Rser=5m
C22: cap; 0.1µ; V=16 Irms=0.6 Rser=0.05
C23: cap; 10µ; V=10 Irms=1.25 Rser=5m
C24: cap; 0.1µ; V=16 Irms=0.6 Rser=0.05
C25: cap; 10µ; V=10 Irms=1.25 Rser=5m
C26: cap; 0.1µ; V=16 Irms=0.6 Rser=0.05
D1: diode; DI_BAS116
D2: diode; CUS10S30
D3: diode; CUS10S30
R3: res; 300k; tol=1 pwr=0.25
R4: res; 30k; tol=1 pwr=0.25
R5: res; 6.8k; tol=1 pwr=0.25
R6: res; 1.8k; tol=1 pwr=0.25
R7: res; 1k; tol=1 pwr=0.25
R8: res; 100; tol=1 pwr=0.5
R9: res; 6.8k; tol=1 pwr=0.25
R10: res; 100
U1: opamp2; OPAx134
U2: opamp2; OPAx134
U4: opamp2; TL07XH_TL08XH
U5: opamp2; MCP6001
U6: opamp2; TL07XH_TL08XH
V1: voltage; PWL file=AD9833_500Hz.txt; Rser=200
V2: voltage; 12
V3: voltage; 5; Rser=312m
V4: voltage; 12; Rser=0.05
Named nets: 0, nAD9833, nSingen, nVdd12, nVss, n1, nFiltered, nAmplified, nProbe, nBuffer, nCath, nVdd5, nADCBuf, nADC
.tran 0 50m 0 1u startup
.include OPAx134.txt
.include BAS116.txt
.include CUS10S30.lib
.include MCP6001.txt
.include tl07xh_tl08xh.txt
