ashertok1/BowelProbe/LTspiceSim/Rail-12V.asc

C1: cap; 4.7µ; Rser=10m
C2: cap; 1µ
C3: cap; 1µ; Rser=10m
C4: cap; 4.7p
C5: cap; 4.7µ; Rser=10m
D1: schottky; SDB160WS
L1: ind2; 4.7µ; Rser=.1
L2: ind2; 4.7µ; Rser=.1
R1: res; 1Meg
R2: res; 71.5K
Rload: res; 1G
U2: LT8330
V1: voltage; 12; Rser=0.05
Named nets: 0, nVdd12, nVss
.tran 0 2m 0 100n startup
K1 L1 L2 0.97
.MODEL SDB160WS D(IS=15.7u RS=42.0m BV=60.0 IBV=500u CJ0=133p M=0.333 N=1.70 TT=7.20n)
