ashertok1/BowelProbe/LTspiceSim/Rail5V.asc

C1: cap; 0.1µ; V=16 Irms=0.6 Rser=0.05 Lser=250p
C2: cap; 10µ; V=10 Irms=1.25 Rser=5m Lser=500p
R1: res; 1k
R2: res; 1G
U1: LT1086-5
V1: voltage; 12V; Rser=0.05
Named nets: 0, nVdd12, nVdd5
.tran 50m startup
