ashertok1/BowelProbe/LTspiceSim/Stage1Singen_Buffer.asc

AD9833: voltage; SINE(0.6 0.3 500)
C1: cap; 10µ
C2: cap; 0.1µ; V=16 Irms=0.6 Rser=0.05
C3: cap; 10µ; V=10 Irms=1.25 Rser=5m
C4: cap; 0.1µ; V=16 Irms=0.6 Rser=0.05
C5: cap; 10µ; V=10 Irms=1.25 Rser=5m
R1: res; 200
U1: UniversalOpAmp2
V1: voltage; 12
V2: voltage; 5; Rser=312m
V3: voltage; 12; Rser=0.05
Named nets: 0, nVss, nVdd5, nVdd12, nSingen, nBuf1, nAD9833
.tran 50m startup
