ashertok1/BowelProbe/LTspiceSim/Stage2Filter.asc

C1: cap; 0.1µ; V=16 Irms=0.6 Rser=0.05
C2: cap; 10µ; V=10 Irms=1.25 Rser=5m
C3: cap; 0.1µ; V=16 Irms=0.6 Rser=0.05
C4: cap; 10µ; V=10 Irms=1.25 Rser=5m
C5: cap; 1n; V=50 Irms=0.2 Rser=300m
C6: cap; 2.2n; V=50 Irms=0.15 Rser=250m
R2: res; 6.8k; tol=1 pwr=0.25
R4: res; 6.8k; tol=1 pwr=0.25
U1: opamp2; OPAx134
V1: voltage; 12
V2: voltage; 5; Rser=312m
V3: voltage; 12; Rser=0.05
VHF: voltage; SINE(0 10m 10Meg)
VSin: voltage; SINE(0 300m 500); Rser=1m
Named nets: 0, nVss, nVdd5, nVdd12, n1, nFiltered, nBuf1
.tran 0 50m 0 1u startup
.include OPAx134.txt
