ashertok1/BowelProbe/LTspiceSim/Stage3Amplify.asc

C1: cap; 0.1µ; V=16 Irms=0.6 Rser=0.05
C2: cap; 10µ; V=10 Irms=1.25 Rser=5m
C3: cap; 0.1µ; V=16 Irms=0.6 Rser=0.05
C4: cap; 10µ; V=10 Irms=1.25 Rser=5m
R1: res; 30k; tol=1 pwr=0.25
R2: res; 1.8k; tol=1 pwr=0.25
U1: opamp2; OPAx134
V1: voltage; 12
V2: voltage; 5; Rser=312m
V3: voltage; 12; Rser=0.05
Vfilter: voltage; SINE(0 300m 500)
Named nets: 0, nVss, nVdd5, nVdd12, nAmplified, nFiltered
.tran 0 50m 0 1u
.include OPAx134.txt
