ashertok1/BowelProbe/LTspiceSim/Stage5SuperPeakDetector_Buffer.asc

C1: cap; 0.1µ; V=16 Irms=0.6 Rser=0.05
C2: cap; 10µ; V=10 Irms=1.25 Rser=5m
C3: cap; 0.1µ; V=16 Irms=0.6 Rser=0.05
C4: cap; 10µ; V=10 Irms=1.25 Rser=5m
C5: cap; 0.1µ; V=16 Irms=0.6 Rser=0.05
C6: cap; 0.1µ; V=16 Irms=0.6 Rser=0.05
C7: cap; 10µ; V=10 Irms=1.25 Rser=5m
C8: cap; 0.1µ; V=16 Irms=0.6 Rser=0.05
C9: cap; 10µ; V=10 Irms=1.25 Rser=5m
D1: diode; DI_BAS116
D2: diode; CUS10S30
D3: diode; CUS10S30
R1: res; 300k; tol=1 pwr=0.25
R2: res; 1k; tol=1 pwr=0.25
U1: opamp2; TL07XH_TL08XH
U2: UniversalOpAmp2
V1: voltage; 12
V2: voltage; 5; Rser=312m
V3: voltage; 12; Rser=0.05
VProbe: bv; V=table(time, 0, 2.5, 15m, 3.0, 30m, 2.0) * sin(2*pi*500*time)
Named nets: 0, nVss, nVdd5, nVdd12, nCath, nBuffer2, nADCBuf, nADC
.tran 0 50m 0 1u startup
.include BAS116.txt
.include CUS10S30.lib
.include tl07xh_tl08xh.txt
