ashertok1/BowelProbe/(list of files, drawings)

Other design files:
freerouting.dsn
