ashertok1/BowelProbe/bowelProbe.kicad_pcb

## KiCad design bowelProbe.kicad_pcb (2026-07-08)

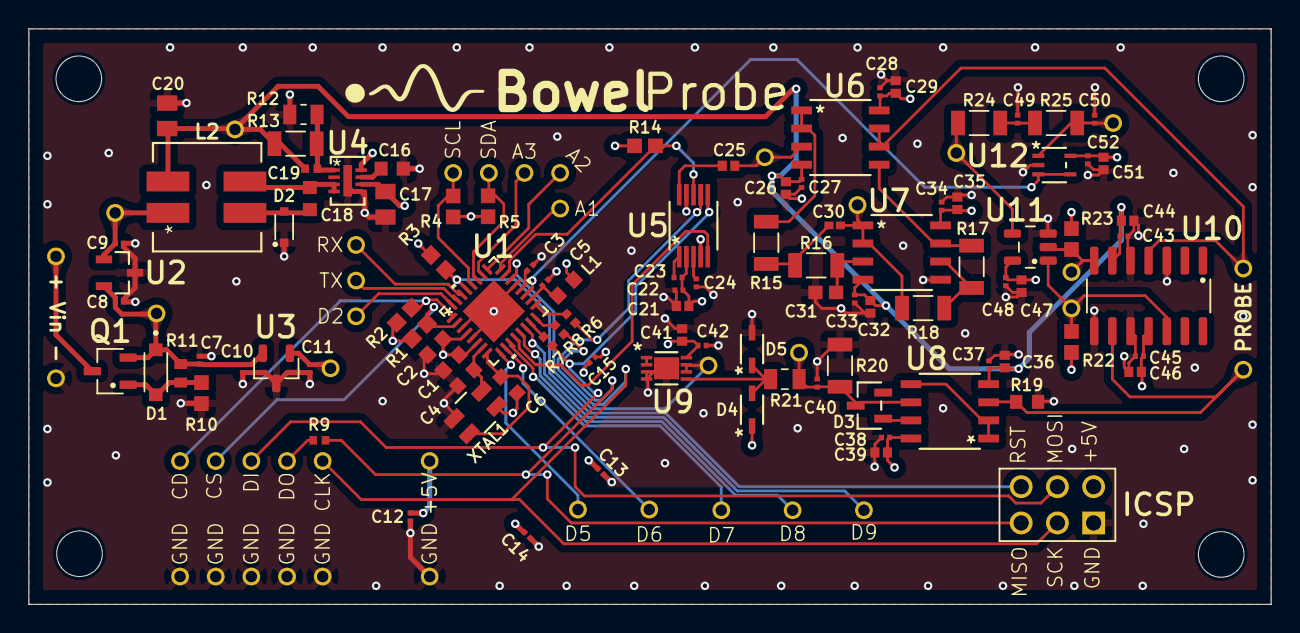
[picture p49: board bowelProbe.kicad_pcb from above]

Board: 4 copper layers, 87.1 x 40.4 mm, 130 parts (0 on the bottom side), 64 nets.

Parts:
A1, A2, A3: Conn_01x01; CT3149-0
C1, C2, C16, C18: 1u; Cap1uF
C3, C5, C7, C8, C9, C10, C11, C12, C13, C14, C15, C22, C23, C24, C27, C28, C33, C34, C37, C38, C40, C42, C43, C45, C48, C49, C50, C52: 0.1u; Cap0.1uF
C4, C6: 18p; Cap18pF
C17, C20: 4.7u; Cap4.7uF
C19: 4.7p; Cap4.7pF
C21, C25, C26, C29, C32, C35, C36, C39, C41, C44, C46, C47, C51: 10u; Cap10uF
C30: 2.2n; Cap2.2nF
C31: 1n; Cap1nF
D1: BZT52B12
D2: SchottkyDiode; SchottkyReplacement
D2#2, D5, D6, D7, D8, D9: Conn_01x01; CT3149-0
D3: DiodeLowLeak
D4, D5#2: DiodeClamper
ICSP: Conn_02x03_Odd_Even; Dupont2x3
J1, J2: Conn_01x08; microSD
J17: Conn_01x01; CT3149-0
J18, J19, J20, J21, J22, J23, J24, J27, J28, J29, J30, J31, J32: Conn_01x01; CT3149-2
J25, J26: Conn_01x01; CT3149-5
L1: 10u; Inductor10uH
L2: SRF0703-4R7M; Inductor4.7uReplacement
Q1: AO3407A
R1, R2, R3, R4, R5, R10, R14, R22, R23: 10k; Resistor10k
R6, R7, R8, R9: 47; Resistor47
R11: 100k; Resistor100k
R12: 71.5k; Resistor71.5k
R13: 1M; Resistor1M
R15, R16: 6.8k; Resistor6.8k
R17, R24, R25: 30k; Resistor30k
R18: 1.8k; Resistor1.8k
R19: 100; Resistor100
R20: 300k; Resistor300k
R21: 1k; Resistor1k
RX: Conn_01x01; CT3149-0
SCL: Conn_01x01; CT3149-0
SDA: Conn_01x01; CT3149-0
TX: Conn_01x01; CT3149-0
U1: ATmega328P
U2: LM3480IM3-12/NOPB; LM3480IM3-12_NOPB
U3: TLV76050DBZR
U4: LT8330
U5: AD9833BRMZ; AD9833
U6, U8: TL072ACDR; TL072smd
U7: OPA2134UA/2K5; OPA2134smd
U9: MCP6002T-E/MC; MCP6002smd
U10: LM319MX/NOPB; LM319MX_NOPB
U11: SN74LVC1G86DBVR
U12: Buffer
XTAL1: TSX-3225 16.0000MF18X-AC3; Crystal16MHz

Connections:
/+5V: C1.1, C2.1, C11.1, C12.1, C13.1, C14.1, C15.1, C21.1, C22.1, C23.2, C41.1, C42.1, C47.1, C48.1, C51.1, C52.1, D4.1, ICSP.2, J1.1, J21.1, L1.2, R1.1, R2.1, R3.2, R4.2, R5.2, R14.2, R22.2, R23.1, U1.4 (VCC), U1.6 (VCC), U3.1 (OUT), U5.2 (VDD), U9.8 (VDD), U11.5 (Vcc), U12.5 (V+)
/+12V: C9.1, C17.2, C28.2, C29.2, C34.2, C35.2, C38.2, C39.2, C45.1, C46.1, J19.1, L2.1, U2.1 (OUT), U4.6 (VIN), U4.8 (EN/UVLO), U6.8 (VCC+), U7.8 (V+), U8.8 (VCC+), U10.11 (V+)
/-12V: C19.1, C20.2, C26.1, C27.1, C32.1, C33.1, C36.1, C37.1, C43.2, C44.2, J22.1, L2.2, R13.2, U6.4 (VCC-), U7.4 (V-), U8.4 (VCC-), U10.6 (V-)
/A: J30.1, R22.1, U10.12 (OUT1), U11.1 (A)
/A1: A1.1, U1.24 (PC1)
/A2: A2.1, U1.25 (PC2)
/A3: A3.1, U1.26 (PC3)
/B: J29.1, R23.2, U10.7 (OUT2), U11.2 (B)
/CD: J1.8, R2.2, U1.1 (PD3)
/CLKO: U1.12 (CLKO), U5.5 (MCLK)
/D2: D2#2.1, U1.32 (PD2)
/D5: D5.1, U1.9 (PD5)
/D6: D6.1, U1.10 (PD6)
/D7: D7.1, U1.11 (PD7)
/D9: D8.1, U1.13 (PB1)
/D10: D9.1, U1.14 (PB2)
/MISO: ICSP.5, R8.2, R9.2
/MOSI: ICSP.4, J1.6, R7.2, U5.6 (SDATA)
/PDout: C50.2, J32.1, R25.2, U12.1 (+IN)
/PDoutBuf: U1.19 (ADC6), U12.3 (-IN), U12.4 (OUT)
/RX: RX.1, U1.30 (RXD)
/SCK: ICSP.3, J1.4, R6.1, U5.7 (SCLK)
/SCL: R4.1, SCL.1, U1.28 (SCL)
/SDA: R5.1, SDA.1, U1.27 (SDA)
/TX: TX.1, U1.31 (TXD)
/VADC: J28.1, U1.22 (ADC7), U9.6 (VINB-), U9.7 (VOUTB)
/VADCbuf: D4.2, D5#2.1, R21.2, U9.5 (VINB+)
/Vampbuf: J25.1, U6.6 (2IN-), U6.7 (2OUT), U10.4 (+IN1)
/Vamplified: R17.1, U6.5 (2IN+), U7.7 (OUTB)
/Vfiltered: C30.1, J24.1, R18.2, U7.1 (OUTA), U7.2 (INA-)
/Vin: J18.1, Q1.3
/VinReverse: C7.1, C8.1, C10.1, D1.C, J20.1, Q1.2, R11.2, U2.2 (IN), U3.2 (IN)
/Vprobe: J26.1, R19.1, U8.3 (1IN+), U10.9 (+IN2)
/Vsinbuf: R15.1, U6.1 (1OUT), U6.2 (1IN-)
/Vsingen: C25.2, J23.1, U6.3 (1IN+)
/Y: J31.1, R24.1, U11.4 (Y)
/nReset: ICSP.6, R3.1, U1.29 (nRESET)
/nSS: J1.7, R1.2, U1.2 (PD4)
/nSS_Sin: R14.1, U1.23 (PC0), U5.8 (FSYNC)
GND: C1.2, C2.2, C3.2, C4.1, C5.2, C6.1, C7.2, C8.2, C9.2, C10.2, C11.2, C12.2, C13.2, C14.2, C15.2, C16.2, C17.1, C20.1, C21.2, C22.2, C24.1, C26.2, C27.2, C28.1, C29.1, C31.1, C32.2, C33.2, C34.1, C35.1, C36.2, C37.2, C38.1, C39.1, C40.2, C41.2, C42.2, C43.1, C44.1, C45.2, C46.2, C47.2, C48.2, C49.1, C50.1, C51.2, C52.2, D2.C, D5#2.2, ICSP.1, J2.1, J2.4, J2.5, J2.6, J2.7, J2.8, J17.1, R10.1, R12.2, R19.2, R20.2, U1.3 (GND), U1.5 (GND), U1.21 (GND), U1.33 (GND), U2.3 (GND), U3.3 (GND), U4.5 (GND), U4.9 (GND), U5.4 (DGND), U5.9 (AGND), U7.5 (INB+), U9.3 (VINA+), U9.4 (VSS), U9.9 (EPAD), U10.3 (GND1), U10.5 (-IN1), U10.8 (GND2), U10.10 (-IN2), U11.3 (GND), U12.2 (V-), XTAL1.2, XTAL1.4
unnamed: C18.1, D2.A, L2.4
unnamed: C18.2, L2.3, U4.3 (SW), U4.4 (SW)
unnamed: C30.2, R15.2, R16.1
unnamed: C49.2, R24.2, R25.1
unnamed: D1.A, Q1.1, R10.2, R11.1
unnamed: J1.5, R9.1
unnamed: C40.1, D3.3, J27.1, R20.1, R21.1, U8.6 (2IN-)
unnamed: C3.1, U1.20 (AREF)
unnamed: C5.1, L1.1, U1.18 (AVCC)
unnamed: R7.1, U1.15 (MOSI)
unnamed: R8.1, U1.16 (MISO)
unnamed: R6.2, U1.17 (SCK)
unnamed: C4.2, U1.7 (XTAL1), XTAL1.1
unnamed: C6.2, U1.8 (XTAL2), XTAL1.3
unnamed: C19.2, R12.1, R13.1, U4.1 (FBX)
unnamed: C16.1, U4.7 (INTVCC)
unnamed: C24.2, U5.3 (CAP/2.5V)
unnamed: C23.1, U5.1 (COMP)
unnamed: C25.1, U5.10 (VOUT)
unnamed: C31.2, R16.2, U7.3 (INA+)
unnamed: R17.2, R18.1, U7.6 (INB-)
unnamed: U8.1 (1OUT), U8.2 (1IN-), U8.5 (2IN+)
unnamed: D3.1, U8.7 (2OUT)
unnamed: U9.1 (VOUTA), U9.2 (VINA-)
