ashertok1/BowelProbe/(commit log)

2026-01-12 init commit
    [bowelProbe.kicad_sch]
2026-01-16 Schematic Updates
    Found exact parts for op amps and diode. Imported their symbols, footprints, and .step files. Corrected various wiring mistakes.
    To do:
    - Add 0-5V voltage control/clamping at RC output
    - Add buffer following this clamping circuit
    - Connect all +5V to each other, -12V to each other, etc.
    - Find/determine footprints for all other parts (design if have to)
    - Do PCB layout
    [1N5817.STEP, MCP6002-E_P.STEP, OPA2134PA.STEP, TL072ACP.STEP]
2026-01-19 PCB Finalized
    Finished PCB layout and routing. Awaiting final check.
    [bowelProbe.kicad_pcb, bowelProbe.kicad_sch]
2026-03-23 Finished Electronic Schematic, Awaiting Finalizations and Review
    Added many symbols, footprints, and 3d models. Organized design into functional blocks.
    Still need finalized plans and footprints for "demo".
    Next Steps:
    - Finalize "demo" subciruit
    - Review schematic
    - Move on to layout
    - Make code for full device operation
    [AD9833BRMZ.STEP, ATMEGA328P-MUR.STEP, Cap0.1uF.STEP, Cap10uF.STEP, Cap18pF.STEP, Cap1nF.STEP, Cap1uF.STEP, Cap2.2nF.STEP]
2026-03-23 Schematic Finalized and Reviewed, Awaiting Professor Review
    Schematic finalized, corrected, and finished. Awaiting professor review.
    Next steps:
    - PCB layout
    - Programming
    - Update BOM
    [Dupont2x3.STEP, Resistor71.5k.STEP, bowelProbe.kicad_sch]
2026-03-25 LTspice Source Scripting
    Created python script to model sine wave generator (replacement model for chip AD9833 w/o spice model). Additionally began initial pcb placement.
    [bowelProbe.kicad_pcb, bowelProbe.kicad_sch]
2026-03-27 LTspice Simulations
    Necessary LTspice Simulation models and files included in subdirectory "LTspiceSim" of BowelProbe. Simulated power rail generation and the various stages of the analog circuit.
2026-03-27 KiCad Updates
    Added buffer after wave AD9833 sine generation and coupling capacitor (as simulated in LTspice) to address loading on filter stage. Added symbol, footprint, 3D model, and spice model in corresponding folders.
    Updated BOM with this new part and updated PCB layout with buffer parts.
    [Buffer.step, bowelProbe.kicad_pcb, bowelProbe.kicad_sch]
2026-03-28 PCB Layout Progress
    Initial rough layout of parts into corresponding sections. Next up is to formalize signal, power, and SPI flow as well as specific component placements.
    [bowelProbe.kicad_pcb, bowelProbe.kicad_sch]
2026-03-29 Schematic and Layout Updates
    Added 47 ohm resistors to schematic to reduce ringing of SPI through ports and added corresponding info to BOM. Set PCB layout. May make a few more small tweaks.
    [Resistor47.STEP, bowelProbe.kicad_pcb, bowelProbe.kicad_sch]
2026-03-29 PCB Layout Plan Finalized
    Added more stitching capacitors in schematic. Decided on final layout and added necessary vias. Added NPTH M3 mounting holes.
    [bowelProbe.kicad_pcb, bowelProbe.kicad_sch]
2026-03-30 PCB Layout Routed
    Schematic references adjusted and extra stitching capacitors removed. Layout added a few vias and fully routed.
    Layout Finalization:
    - Add ground pours on L1 and L4
    - Add stitching vias
    - Add edge stitching vias
    - Review
    [bowelProbe.kicad_pcb, bowelProbe.kicad_sch]
2026-03-30 PCB Finished
    Added pours and stitching to finish layout. Adjusted BOM to fit JLCPCB expected. Generated CPL file. Various KiCad plugins were downloaded. A folder "PCBA_Files" created to hold BOM, Pick and Place, and Gerber files.
    Final Objectives:
    - Simulate with Ansys HFSS
    [bowelProbe.kicad_pcb, bowelProbe.kicad_sch]
2026-03-30 Slight BOM Adjustments
    [bowelProbe.kicad_sch]
2026-03-30 HFSS File Generation
    Various files generated to be imported into Ansys HFSS for simulation
    [.step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]
2026-03-30 Updated Simulation Files
    [bowelProbe-drl_map.dxf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]
2026-03-30 EMI Simulation Updates
    DXF file imported. Layers were organized and materials were assigned
    [0029364.x_b, 0029474.x_b, 0029502.x_b, 0084060.x_b, 0166742.x_b]
2026-03-31 Part Replacement
    Replaced Coilcraft inductor for an in stock part. Adjusted PCBA files accordingly.
    [Inductor4.7uReplacement.STP, bowelProbe.kicad_pcb, bowelProbe.kicad_sch]
2026-03-31 Part Replacements
    Replaced crystal and schottky diode. Adjusted schematic, PCB, and BOM accordingly. Organized schematic and colored different sections.
    [SchottkyReplacement.STEP, bowelProbe.kicad_pcb, bowelProbe.kicad_sch]
2026-03-31 Fully Reviewed and Cleared For Immediate Order
    [bowelProbe.kicad_pcb, bowelProbe.kicad_sch]
2026-03-31 Update .gitignore
    Show PCBA csvs
2026-03-31 Commit PCBA File CSVs
    [bowelProbe-PickAndPlace.csv, bowelProbeBOM.csv]
2026-04-01 Bowel Probe Images
2026-05-03 HFSS Post-Layout Verification Files
    Generated IPC-2581 and ODB++ files for easy import of PCB and simulation.
2026-06-26 Revision 1 Initial Updates
    - Removed heatsink
    - Swapped 5V regulator for SMT version
    - Added 12V regulation
    - Adjusted regulator input/output capacitors according to datasheets
    - Swapped buffer for TL072 and added buffer stage between amplification and voltage divider stages
    - Fixed decoupling cap issue on V- rail of buffer between sine generation and filtering
    - Added test nodes to each voltage rail and to critical analog nodes
    [LM3480IM3-12_NOPB.STEP, TLV76050DBZR.STEP, bowelProbe.kicad_sch]
2026-06-27 Rev 1 Progress
    - Updated BOM for the SMT +12V and +5V regulators
    - Removed tracks from previous board
    - Deleted heatsink and +5V THT regulator from layout
    - Set an initial layout plan (~80% complete)
    - Updated various silkscreens to signal the proper part and orientation
    - Updated silkscreen for Vin, I2C, and UART pins
    [bowelProbe.kicad_pcb, bowelProbe.kicad_sch]
2026-06-28 Initial Layout (Rev 1)
    Initial layout plan nearly complete. Needs positioning of test points and stitching capacitors as well as any additional vias afterwards. Also considering making available more ATMega channels as space allows after placement and routing.
    [bowelProbe.kicad_pcb]
2026-07-04 Major Updates
    Added architecture for phase detection which consists of 3 major stages: comparator stage, XOR stage, and low pass filter stage
    Parts chosen and files downloaded and organized into corresponding folders
    Simulation of updated circuit coming up soon (note LM311 simulation file used in place of LM319 due to no available file for LM319)
    Added pull up resistors for I2C lines
    [LM319MX_NOPB.step, LM393ADR.step, SN74LVC1G86DBVR.step, bowelProbe.kicad_sch]
2026-07-04 Spice Updates
    Updated analog logic to simulate phase detector stage. This stage can be seen with the voltage divider stage. In simulating this, symbols for LM311 and the XOR gate were auto generated from their lib file subcircuit.
2026-07-04 Schematic Change
    Very minor change: adjusted phase detector low pass stage to be second order low pass with 30k resistors and 0.1 uF capacitors.
    [bowelProbe.kicad_sch]
2026-07-04 Final Major Schematic Architecture Updates (Rev 1)
    Added architecture for reverse polarity protection. Added parts files necessary for this circuit and organized to the proper folders. Created spice files for PMOS and zener diode parts in reverse polarity protection circuit.
    [AO3407A.step, BZT52B12.step, Resistor100k.step, bowelProbe.kicad_sch]
2026-07-05 Reverse Polarity Protection Simulation
    Simulated reverse polarity circuit. Must update schematic values and add Rgs and Cout.
2026-07-05 Schematic Rough Draft Finished
    Updated circuit for reverse polarity protection and fully updated BOM. Exported BOM to corresponding folder.
    [bowelProbe.kicad_sch]
2026-07-05 Schematic/Layout
    Finished checking schematic, all looks good. Added remaining parts from schematic into layout (including test nodes). Next step is to plan layout for rough draft.
    [bowelProbe.kicad_pcb]
2026-07-06 BOM Revision
    Revised BOM for in stock JLCPCB parts.
    [bowelProbe.kicad_sch]
2026-07-07 Layout Update
    Schematic rechecked and passed check #2. Initial rough draft layout nearly complete; just need to add stitching capacitors. Silkscreen text sizes and thicknesses changed.
    [bowelProbe.kicad_pcb, bowelProbe.kicad_sch]
2026-07-07 Layout Rough Draft Done
    Placed all components where needed. Exposed remaining I/O pins on ATMega for miscellaneous use. Expected vias and stitching caps added. More stitching caps and vias will be added as necessary throughout and after routing. Considering possibility of moving logo and extra pin placements. Layout review coming up soon.
    [bowelProbe.kicad_pcb, bowelProbe.kicad_sch]
2026-07-08 Layout and Routing Finished
    Layout rough draft checked and cleared, routing finished on all layers, stitching caps added and schematic updated accordingly. Awaiting final board check before clearing for manufacture.
    [bowelProbe.kicad_pcb, bowelProbe.kicad_sch]
2026-07-09 Output Files
    All checks finished. Output files generated, including .pos and .gbr (on top of the already generated BOM file).
